prunkdump/arduino-variometer/Modifications/V3/CJMCU-117- Modification du MPU.JPG

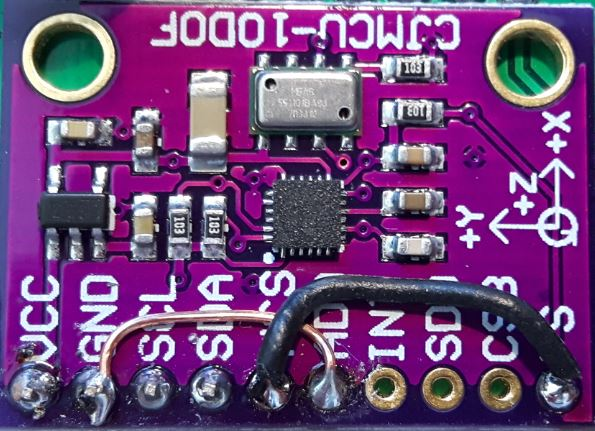
Modifications/V3/CJMCU-117- Modification du MPU.JPG
