prunkdump/arduino-variometer/Modifications/V3/connecteur FDTI.pdf

Problème de temperature

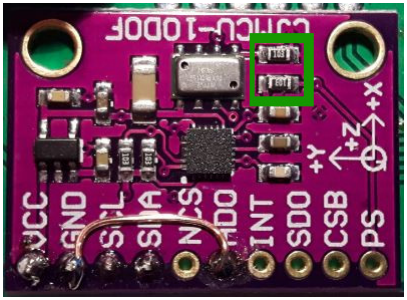
[picture p2: figure]

1- | Connecter la pin AD0 à la pin GND
2- | Connecter la pin NCS à la pin PS

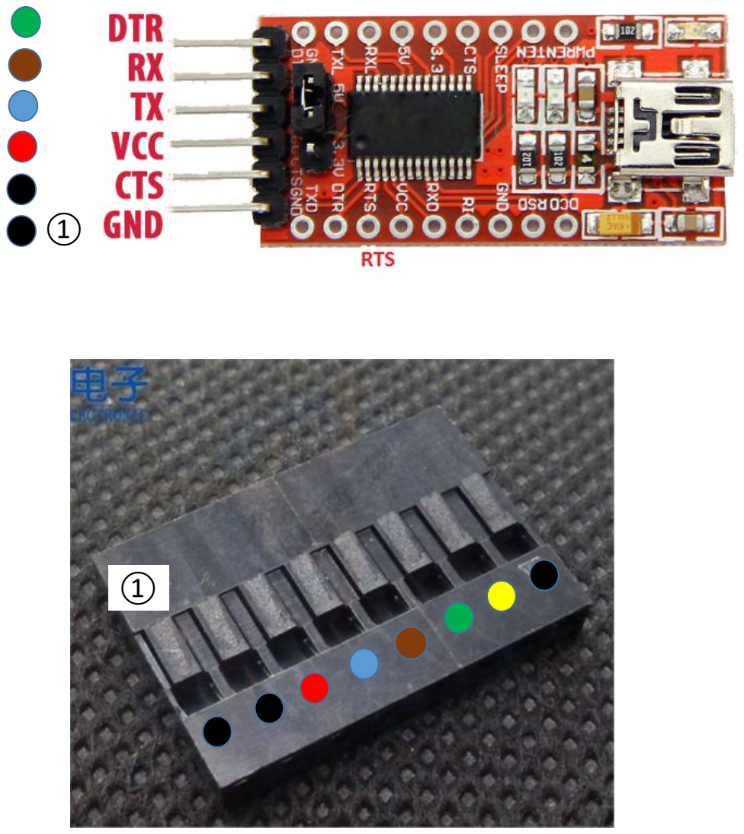
[picture p3: page 2]

①

①

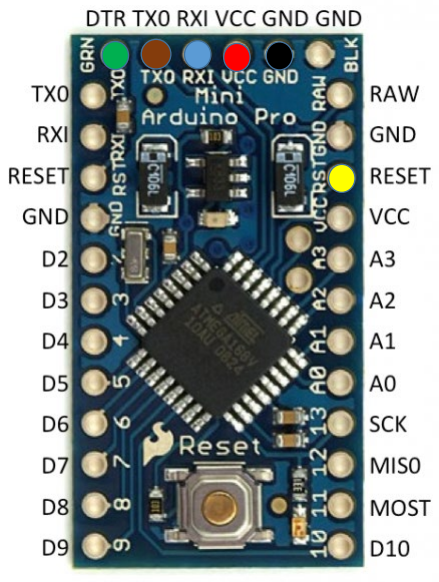
[picture p4: figure]

De gauche à droite écran dessus
Fil | arduino | Connecteur
1 MARRON | GND | GND FTDI
2 ORANGE | GND | CTS FTDI
3 JAUNE | VCC | VCC FTDI
4 ROUGE | RX | TX
5 MARRON | TX | RX
6 VERT | DTR | DTR
7 BLEU | RST | RESET
8 NOIR | GND | GND
