prunkdump/arduino-variometer/(threads)

Thread 1 (2016-12-30):

Thanks

hw999, 2016-12-30:
Hi prunkdump

thanks for publishing your vario solution. It was very helpful for my own project - especially vertaccel and kalmanvert. Performs really nice.

I plan to do make an enhanced version where speed also goes into the equation, known as TECS.
There are already calculations available. But the ones I know don't make a fusion of vertaccel, pressure and speed.
I would like to have this in a Kalman filter - for the time being I lack the knowledge how to do that.

Do you maybe have some hints ?

regards Andi

prunkdump, 2017-01-01:
Hi Andi !

I'am happy that you find my Kalman code helpful ! It was the reason that motivate me starting this project.

I'am interested about your project and how your embed my code. I need as much feedbacks as possible to improve my libraries. Can you send me some ?

This week a have a lot a work. But I can send you a three dimensional Kalman code. I just need a little time to writing it well. But be careful that it will be more computer intensive.

Last question. Do you use your MPU9250 with a 3.5V arduino ? I have some trouble using my Kalman filter with only 3.5V (Atemega328P + MPU9250 + ms5611). But maybe it's an hardware problem.

Maybe you can email me on :

prunkdump at gmail dot com

So I can send you private messages.

Regards, Baptiste.

hw999, 2017-01-17:
Hi Baptiste

I was late with an answer because I didn't notice your reply. Did receive my email ?

kostashellas, 2017-05-03:
Hi Baptiste,
Do you consider changing AVR to something like SAMD21, more performance, memory.
I have a little project that I'm working on the last 6 months and I've reached the Arduino micro limits that's why I've

kostashellas, 2017-05-03:
I'm migrating the entire project to MicroZero that has also SD build-in.
I'm integrating to it your 5611 code and adding the GPS functionality.  All information send to the user   via voice messages thru the headsets.

Best, Kostas

prunkdump, 2017-05-03:
Hi Kostas !

Currently I try to finish my code for Atmega328P as it is the most common hardware used by Arduino hobbyist.

But I can help you if you want. You just want an ms5611 library for cortex M0 ?

Regards, Baptiste.

Thread 2 (2017-04-30):

Moved to variometer kits

jpg63, 2017-04-30:
Le son est un peu fort et il serait intéressant de le régler

Priorité : Indispensable

solution :

Pour le volume c'est effectivement possible de le régler avec le code. Je comptais faire la modif. Il faut remplacer tous les toneAC(freq) en toneAC(freq, VOLUME) avec un volume entre 1 et 10. Mais encore une fois il faut que j'explique comment mettre à jour le code.

van-hurlu, 2017-04-30:
Très facile mettre le code à jour, je l'ai fait pour arrivé à faire fonctionner le baro
si j'ai pigé ma manip
il suffit d'ajouter ,5 juste après la valeur freq dans le code
ou mieux de créer un int vol
et de mettre ,vol après la valeur freq dans le code

prunkdump, 2017-04-30:
Continuez la discution sur variometer-kits.

Closed 2017-04-30.

Thread 4 (2017-04-30):

Enregistrement des données

jpg63, 2017-04-30:
Le vario enregistre toutes les données dès que le gps est fixer, il serait plus judicieux que l'enregistrement débute au début du vol, vitesse supérieur à 3km/h et alti variant de 3m

il serait important d'ajouter l'altitude baro dans le fichier

prunkdump, 2017-04-30:
Continuez la discution sur variometer-kits.

Closed 2017-04-30.

Thread 6 (2017-06-12):

XC Track implementation

YgorTN, 2017-06-12:
Hi Prunk Dump,
I have done several flights with this setup: MS5611, LCD 5110, Speaker and Bluetooth HC-05 using your code (Commits on May 23, 2017 - send vario sentences without GPS). I used it also with XC Soar Android app.

I'm more than satisfied with its performance. Thank you for sharing your idea.

Another, probably more suitable app for paragliders available on Android store is XC Track.
The only problem is, that this app does not support lxnav bluetooth sentence protocol.
This app support only these comercial varios e.g.: FlyNet, BlueFly Vario etc.
http://xctrack.org/External_Sensors.html

Do you think that there is an option to build in some extra protocol (e.g. same as BlueFly Vario), that can user choose in code to make your vario functioning with XC Track?

Thank you.

Regards, Igor

prunkdump, 2017-06-13:
Hi Igor !

Have you tried the XCtrack setup in real condition ? Because on the changelog :

http://xctrack.org/Change_Log.html

there is  :
---------------------------
2016-05-26 0.5.1.2 (development version)

    XCTracer support (baro data only, protocols: XCTRACER, LK8EX1, LXWP0)
---------------------------

So XCtrack should already support LxNav sentences.

Regards,

Baptiste.

YgorTN, 2017-06-14:
Hi Baptiste,

Sure, I've tried the XC Track setup in real condition. I can only connect my HC-05 BT module to the app, but I can't get any measured pressure data in 'Calibration'.

I've tried to switch 'Atmospheric pressure sensor' into option 'Use internal barometer' in the app settings (My phone LG G3 has internal pressure sensor) and in 'Calibration' I see mearured data in real time and vario is working  (not precisely).

In addition, there is no option to choose a specific device or protocol as it is possible in XC Soar app.

I've also tried to use antoher Android smartphone (without internal sensor), but it aslo hasn't been working.

Regards,

Igor

prunkdump, 2017-06-14:
Hi Igor !

It's seems that XCTrack need a higher frequency for the LxNav sentences. If you still have the same version of the code. Try to change :

#define VARIOMETER_SENTENCE_DELAY 2000

in

#define VARIOMETER_SENTENCE_DELAY 500

Baptiste.

YgorTN, 2017-06-15:
Hi Baptiste,

I've already tried to experiment with sentence frequency in range 100 ms - 2000 ms including your suggestion 500 ms. Unfortunately, without any success.

Today I have found this: https://www.xctracer.com/en/faq/?oid=1856&lang=en

The XCTracer support these protocols:
#supported protocols are None, XCTRACER, LK8EX1 or LXWP0

XCTrack (Android): BLE string XCTRACER, forwardGPSSentences=no

Whereas, XCSoar (Android, Kobo): BLE string LXWP0, forwardGPSSentences=yes, choose LXNAV as driver in XCSoar

So this is probably the reason, why current setup works only with XCSoar app.

Igor

prunkdump, 2017-06-17:
I don't think that this is the origin of the problem. It is just that XCTrack understand the "XCTRACER" sentences. So it is possible to send them directly.

Few months ago someone used this code with XCTrack with small adaptations. So it is possible. Sadly I don't have a device to try XCTrack myself. I will try to recontact him to know how he setup the code.

Baptiste.

YgorTN, 2017-06-19:
Hi Baptiste,
That would be perfect, thank you.

Igor

prunkdump, 2017-08-22:
Hi Igor.

The code now support XCTrack with the LK8000 NMEA sentences !

You have just to change in librairies/VarioSettings/VarioSettings.h :

#define VARIOMETER_SENT_LXNAV_SENTENCE
to
#define VARIOMETER_SENT_LK8000_SENTENCE

Thank you very much for the bug report !

Baptiste.

Closed 2017-08-22.

Thread 7 (2017-06-19):

BMP280

Hasi123, 2017-06-19:
Hi,

Thanks for sharing your project. I have a suggestion for you: You could try to implement the Bosch BMP280 barometer sensor. It is much cheaper, than the MS5611 and has almost the same performance.

prunkdump, 2017-06-21:
Yes you're right, this need to be added to the project !

Even if I think that the BMP280 does not really have almost the same performance than the ms5611.

I contact you when I have found the time to work on it.

Thanks !

Baptiste.

Hasi123, 2017-08-26:
I made a quick and dirty adaptation for the BMP280 using Adafruit's library. It works, but is probaby very inefficient. https://github.com/Hasi123/arduino-variometer

Hasi123, 2017-09-03:
I changed Adafruit's library to use your fastwire communication.

prunkdump, 2017-09-13:
Hello Hasi !

I'am really sorry ! I accidentally removed watching on this issue so GitHub don't send me emails when you put your comments.

I checked you work and it seems good ! Have you tried in flight ?

The only problem is that you feed the Kalman filter each time you get a new value from the accelerometer, regardless of if you have a new value from the barometer.

When I have some times, I will try to adapt you code.

Thanks you for the help !

Hasi123, 2017-09-13:
Since I have a broken leg, I cannot test it in flight yet. As soon as I`m able, I will test it.

Hasi123, 2017-10-27:
hi

Hasi123, 2017-10-27:
Finally I can fly again and was able to test the vario. It worked quite well even with my faulty Code. It would be nice to see it implemented with your routine with the interrupts.

Hasi123, 2017-10-28:
So new update: I read through the BMP280 datasheet and the sensor reads the pressure at a stable frequency internally in normal mode, so there is no need to use timers. I changed the BMP280's settings a bit to better suite our application.

Hasi123, 2017-11-20:
Finally I could test the vario in thermally conditions and it works like a charm! I did a 30km flight in the middle of november. It is very accurate and does not suffer from sudden pressure changes due to an increase or decrease in speed, that I sometimes had with my old homemade vario (only barometer with a low pass filter).

prunkdump, 2017-11-22:
That's great !!!

I have just ordered a BMP280 board to improve the code with you.

The BMP280 have multiple modes. The only drawback of using the "continous" mode is that it consume more energy.

When I have the time to work on It I will sent to you a version of the code with timers interrupts. So you can compare the two versions.

I'm also very interested by you 1.8V setup !

Good job !

Baptiste.

m00nsp3ll, 2019-04-05:
bmp280 have also temperature sensor on it, it could be useful to implement temperature data into vario if bmp280 usage is possible

Hasi123, 2019-04-15:
The temperature data from the barometer is actually used to compensate altitude readings with both the ms5611 and the BMP280.

It would be interesting to test the BMP388, because it has even more resolution and accuracy than older sensors...

prunkdump, 2019-04-27:
The code now support the BMP280 barometer.

Thanks for the report.

Closed 2019-04-27.

Thread 8 (2017-07-29):

Vertical speed but no change in altitude

sbishop61, 2017-07-29:
HI,\ a great project and contribution.

I have a breadboard set up with Pro Mini,  display and MPU9250 & MS5611.

When it is not moving on the desk, the altitude does not change but there is always a vertical speed reported; typically +0.3. After 5 minutes the altitude is still the same and the there has always been a vertical speed.

I thought that the vertical acceleration from the DMP was used in a kalman filter applied to the pressure (altitude) reading. I don't understand how if the altitude is not changing.

Any help appreciated.

Regards,\Stephen

prunkdump, 2017-07-31:
Hi Stephen !

I very happy you like my project.

The kalman filter is not a "long term" filtering algorithm. It use just, each time, the previous step and the new value. Search for "kalman filter" on the web for an introducing article.

Now what's happen in you case. The DMP is bad calibrated so it sent constantly an upward force. The barometer sent nearly always the same altitude.

-> on one step the kalman filter receive 235m and an upward force.
-> as the upward force must increase the vertical speed it assume a +0.3 vertical speed.
-> the next step, the kalman filter receive again 235m and the same upward force. This is not coherent with the privious measure as the altitude have not encreased. So the kalman filter try to make the best assumption.

There is an upward force so the vertical speed must be encrease. But the altitude remain the same so vertical speed must be 0. So il choose 0.3 again.

Otherwise you need to calibrate your gps. Use the "calibration" or the "calibration_nointerractive" sketch.

Don't hesitate if you have questions.

Regards.

Baptiste.

sbishop61, 2017-07-31:
Baptiste,

I assumed that the kalman was used to smooth/filter the pressure readings and that the vertical velocity was calculated from the change in the compensated altitude. In that scenario a constant acceleration might effect the filter output but if the altitude was constant the vertical velocity would always be zero.

I have tried to use the calibration routines but it is hard when on a breadboard. When I ran the calibration it always failed saying BAD measurement.

regards,

Stephen

________________________________
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

prunkdump, 2017-08-02:
Hi Stephen !

Are you sure that you always obtain bad measurement ? Normally you should obtain at least one good measure for each orientation the first time. The second time you get "bad" measure if the acceleroleter is less stabilized than the fist time. Do not touch the breadboard during measurement.

Another tips. Take a box and fix the breadboard inside with tape. So you can use the calibration_nointeractive sketch following this procedure :

https://www.youtube.com/watch?v=fc0vIsZJvsw

Good luck.

Baptiste.

prunkdump, 2017-08-22:
Hi Stephen !

It's seems that you find the problem.

I close the issue.

Baptiste.

Closed 2017-08-22.

Thread 9 (2017-08-02):

Suggestion: extra Define to set MPU I2C address to 0x69

sbishop61, 2017-08-02:
Baptiste,
 in order to try and get a prototype into a box to calibrate I have used a cjmcu-117 as I think you have.
Unfortunately there seems to be some short on the board as the I2c address keeps changing from 0x68 to 0x69 and back again. The solution is to set ADO to 1 which holds the address at 0x69.

I can get it to work by editing inv_mpu.cpp where #define GYRO_HW_ADDR (0x68) is set both for MPU6050 and separately for MPU6500.

A suggestion would be to have a define in VarioSettings.h rather than in the C++ file.

regards
Stephen

prunkdump, 2019-04-14:
You can now set the MPU address in VarioSetting.h

Thanks for the report.

Baptiste.

Closed 2019-04-14.

Thread 10 (2017-08-19):

arduino-variometer to android-variometer?

lshachar, 2017-08-19:
I watched the videos on youtube - and your project seems quite impressive!
on my galaxy s4 smartphone there is a bmp180 barometric sensor, and obviously a 9dof sensor.

It appears that none of the currently available android vario apps integrate the 9dof sensor..
Do you think a port to android may be feasible?
I'm trying to figure out if I can do it myself, but I'm not a very good programmer (I'm experienced with arduino, but not at all with android... I might just end up building your project, will take me less time than trying to port the code to android!)
I'll be happy to hear your thoughts about it!

lshachar, 2017-08-19:
hmmm...
[use sensor fusion to improve vario responsiveness ](https://github.com/msarto/AVario/issues/2)

prunkdump, 2017-08-22:
I Ishachar.

Excuse me for this late reply !

Sadly I don't have any practice in Android programming. But I know that :
-> It's possible to use C++ with Android with Android NDK so you can port some part of this code.
-> It's possible to access the 9dof and bmp180 data with Android libraries.

So porting this project to android seems to be possible ! If I find some more info I will send to you the links.

Thanks for the idea !

Baptiste.

Thread 11 (2017-10-19):

vario + bluetooth+ gps = no sentences

lshachar, 2017-10-19:
Hello prunkdump!
I have built a vario using your code. A+++ stuff! thank you!!
I now got a GPS and Bluetooth installed in my vario, and I think I'm onto a bug.

in variometer.ino:323 `#else //!HAVE_GPS`
When there is GPS installed, but GPS didn't get a fix, no sentences will be sent.
I believe that this is unintentional behavior; in this case the vario should send pressure and vario data, neglecting calibrated altitude (since it cannot be calibrated - no GPS).

once GPS gets a fix, calibrated altitude should be sent.
I think that excluding this code (with line 323) when there is GPS and Bluetooth is the problem.
Do you agree?

prunkdump, 2017-10-20:
Hi Ishachar.

No there is no problem. I explain.

When the variometer sent pressure/vario sentences it must be carefull to not sending the sentences at the same time than GPS. Because they use the same serial port. So synchronization is needed between the GPS and the variometer.

So :
-> When the GPS is installed. Pressure/Vario sentences are sent just after the last GPS sentence. It's the GPS that give the rate of the Pressure/Vario Sentences. Search for "lastSentence = true;" in the code. And the GPS sent the sentences even if it didn't get a fix.

-> When there is no GPS installed. The variometer is free to sent the sentences when it want. So there is just a delay between sending. And the "last sentence" code is disabled. This delay can be set in "VarioSettings.h".

Regards,

Baptiste.

jpg63, 2017-10-20:
Salut Baptiste,

tu as du mélanger mon mail avec celui de Ishachar

Pense à lui renvoyer ta réponse

A+

________________________________
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

kostashellas, 2017-10-20:
Hi Baptiste,
That means the vario refresh rate, in case of  GPS, = GPS refresh rate thus
20Hz?

Regards Kostas

On Oct 20, 2017 11:28 AM, "prunkdump" <notifications@github.com> wrote:

Hi Ishachar.

No there is no problem. I explain.

When the variometer sent pressure/vario sentences it must be carefull to
not sending the sentences at the same time than GPS. Because they use the
same serial port. So synchronization is needed between the GPS and the
variometer.

So :
-> When the GPS is installed. Pressure/Vario sentences are sent just after
the last GPS sentence. It's the GPS that give the rate of the
Pressure/Vario Sentences. Search for "lastSentence = true;" in the code.
And the GPS sent the sentences even if it didn't get a fix.

-> When there is no GPS installed. The variometer is free to sent the
sentences when it want. So there is just a delay between sending. And the
"last sentence" code is disabled. This delay can be set in
"VarioSettings.h".

Regards,

Baptiste.

—
You are receiving this because you are subscribed to this thread.
Reply to this email directly, view it on GitHub
<https://github.com/prunkdump/arduino-variometer/issues/11#issuecomment-338141728>,
or mute the thread
<https://github.com/notifications/unsubscribe-auth/ABPYiFmlG5yfHuDyAmC2v53xKtbRdmyIks5suFm0gaJpZM4P_2cq>
.

prunkdump, 2017-10-21:
Yes ! I known that this must be improved !

GPS often use a refresh rate of 0.5Htz. One time every two seconds. And for the Pressure/Vario sentences it's a little bit slow.

Thanks for the report !

defvs, 2018-01-08:
How about using SoftwareSerial, by changing bluetooth pins and completely separating the two ? I know there is a rom space issue, but with a little tweaking it could be almost invisible.

**Français**
Pourquoi on utiliserais pas SoftwareSerial ? On change les pins du bluetooth et on sépare complètement les deux ? Apparement il y a peu de place dans la rom avec le programme mais avec un peu de tweak on peut réussir à négliger l'impact sur le processeur de l'arduino

If you need more help just ask me; si tu veux plus d'infos demande moi

prunkdump, 2018-01-08:
Hi Defvs !

There is two problems with SoftwareSerial :

-> Obviously, SoftwareSerial consume more ROM as the Serial protocol internals are implemented by software and not by hardware.

-> SoftwareSerial (like Serial) use two ring buffers, one for RX and one for TX. The SerialNmea library use only one common buffer and filter the input (RX) characters to keep only the needed NMEA sentences.

Thus we save ROM with optimized code but also SRAM with the only one (small) ring buffer.

But you're right. The drawback is that the code is not portable and only the hardware serial pins can be used.

But if you want, software serial can be easily used inside SerialNmea to use some other pins.

Thanks for the suggestion !

Baptiste.

defvs, 2018-01-08:
Hey ! I'll try and make a port ;)

Le lun. 8 janv. 2018 à 16:20, prunkdump <notifications@github.com> a écrit :

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
--

Merci,
Daniel Thirion (defvs) defvs.daniel@gmail.com

lshachar, 2019-09-11:
I went back to enabling the GPS module on my vario (I decided to disable it back in October 2017..)
And I found the cause of my original issues.
I am using a chinese arduino nano, which has a CH340 chip instead of an FTDI chip. (for USB to serial).
My GPS module, NEO-6m, wasn't able to sink the RX1 pin (on the arduino) to LOW. So even though the GPS module was in fact sending NMEA sentences at 1HZ, the cheap arduino nano did not see that data on its RX1 line.
(I figured that out by using the software serial library, and connecting the GPS TX pin to arduino on a different pin (pin 2). which worked fine.)
Hence, the CH340 is doing something funny - maybe it has a small pull up resistor when it is not trying to send data to the arduino.

In order to solve the problem: I added a PNP transistor (2N4403 I had laying around) between the gps module (TX) and the arduino (RX) that sinks the RX pin to Ground (when the gate goes low - which is connected to the GPS TX pin).
once the arduino received the data on the RX line, I was able to `#define HAVE_GPS` in `variosettings.h` and the info is sent properly on the arduino's TX line (both the gps' NMEA sentences and the vario's LK8000 sentences.

I also learned something else...:
while sending data to the arduino through the serial interface (through UART, which ends up on the arduino's RX1 pin) and at the same time having the GPS module trying to send data (because that's what it does every second)  - I had something goes up in smoke! and that cheap arduino board died. well, probably only the CH340 died as that board won't connect through USB anymore. but otherwise it still works.
I assume that the CH340 tried to drain too much current (both the arduino RX1 and the GPS module should have pullup resistors; once the CH340 was trying to send data it tried to sink both these sources to ground (before the NPN transistor was added) ).
To play it on the safe side I added a SPDT switch on the RX1 pin, and now I disconnect the NPN transistor every time before I upload any code.
(I believe adding a resistor on the transistor's gate, should also keep this from happening again, but I'm not 100% sure that the CH340 burned, and that it happened for the reason I think it did. So I'm playing it safe).

This wouldn't have happened if I used a genuine arduino board.
I wanted to get this information out there in case it help somebody one day.

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

Closed 2020-04-07.

Thread 12 (2017-11-23):

SETTINGS.TXT

pbwild, 2017-11-23:
Hi!
Could you post an example of the SETTINGS.TXT file for the M0 branch?
Man thanks!
Peter

jpg63, 2017-11-23:
https://github.com/prunkdump/arduino-variometer/tree/jpg63-M0-version/libraries/VarioSettings

[https://avatars2.githubusercontent.com/u/4787331?s=400&v=4]<https://github.com/prunkdump/arduino-variometer/tree/jpg63-M0-version/libraries/VarioSettings>

prunkdump/arduino-variometer<https://github.com/prunkdump/arduino-variometer/tree/jpg63-M0-version/libraries/VarioSettings>
github.com
arduino-variometer - Arduino based variometer with accelerometer, screen, gps and sdcard code

Hi, the file SETTINGS.TXT is present in the directory variosetting This file is placed in the root of the SD card

jpg63

________________________________
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

pbwild, 2017-11-25:
Ah yes - found it!
Many thanks!

Thread 13 (2017-11-30):

M0 Accelerometer Calibration

pbwild, 2017-11-30:
Hi,
do you have a tip on how to calibrate the MPU9250 Accelerometer on the M0 branch. I have got the sketch up and running on an Arduino Zero without an SD Card (btw. in the code VarioSettings GnuSettings; needs to be moved outside the #ifdef HAVE_SDCARD for this to work), but I'm not getting very far with the calibration sketches - I don't quite understand what you are doing with Fastwire.
Many thanks,
Peter

jpg63, 2017-11-30:
Hi,

The calibration of the MPU9250 is not yet implemented in this code, it will come later. For the Gnusettings library it is imperative to have an SD card, the MKRZero has one of them. The setting is stored in SETTINGS.TXT at the root of the SD card. Without SD card the code does not work, it will be possible to make changes later but I do not see the interest.

jpg63

________________________________
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

pbwild, 2017-12-03:
OK thanks, looking forward on seeing how you calibrate things on the zero platfom.
Cheers,
Peter

DonCann, 2017-12-08:
I adapted the calibration code t from the samd21 branch to make it work with the zero, doesn't work though, I keep getting this message for any orientation, for instance pointing upward:

accel=(-0.01402, 0.00588, 0.11548)
Standard deviation = 0.62822
BAD measure, not recorded, possible problems are :
-> ambiguous orientation
-> orientation already done with lower standard deviation

Any idea why the orientation is ambiguous?

prunkdump, 2017-12-09:
Hello !

This is not the problem. "Standard deviation" is just the measure of acceleration data "quality". For each orientations, the calibrator record the measure only if the Standard deviation is lower than the previous measure.

The problem is that your accel vector give strange data :
accel=(-0.01402, 0.00588, 0.11548)

Normally, the norm of the vector must be around 1 (due to gravity) with is not the case here. Two possibilities :
-> You MPU9250 does not work well.
-> There is a problem in the Samd21 code.

I have tested the vertaccel_library on Samd21 and it work well. I think than Jpg63 have tested the calibration code without midification.

Can you confirm Jpg63 ?

Don't hesitate if you have questions or if you find something.

Baptiste.

jpg63, 2017-12-09:
Hello The code is that of the original accelcalibrator library and the last MPU library that was tested with the samd21. I did not make any changes other than saving the calibration in memory and on the SD card jpg63

________________________________
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

DonCann, 2017-12-11:
Thank you both for your answers, I’ll test with another mpu and let you know.
Cheers

pbwild, 2017-12-30:
Hi,
I've just got everything up and running on an MKR0, but I'm still unclear on how to calibrate.
Is what DonCann is trying the correct way to proceed?
@DonCann - care to share any progress with your code modification?
Many thanks,
Peter

prunkdump, 2018-01-08:
Hi PbWild !

Which branch do you use ?
-> If you use the master-Samd21 branch the accelerometer calibration is not implemented yet.
-> If you use the jpg63-M0-version branch, the calibration procedure is automatically launched at power On If not already done. And you need to follow there steps :

https://www.youtube.com/watch?v=fc0vIsZJvsw

DonCann, 2018-01-17:
I tested my code with two different mpu-9250 and in both cases got values in the 0.01-0.10 range as I mentionned above.
Will report when I find where the problem.

prunkdump, 2018-01-20:
I'am really sorry ! You're right. There is a bug in the calibrator that can cause overflow with high speed micro controllers.

The bug is corrected in the master branch.

I will send to you a Samd21 version soon.

Sorry again. The problem was not your mpu9250 ...

prunkdump, 2018-01-20:
The problem is now corrected. The "calibration.ino" sketch run and display correct values. But the calibration correction coefficient are still not recorded.

Jpg63 you need to port the last correction to your branch ;)

jpg63, 2018-01-20:
I have already updated my pro-mini branch. For the M0 version, the libraries are very different, I have to look

________________________________
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

pbwild, 2018-02-16:
Hi, any updates on calibration for the M0 branch? Where exactly should the coefficients be saved - eeprom or flash.txt?
Thanks,
Peter

jpg63, 2018-02-16:
Hi,

The parameters are stored in 2. The eeprom of the M0 is removed at each program update. Parameters are taken first on the eeprom and if they are zero, on the SDcard in a specific file

jean-philippe
________________________________
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

kostashellas, 2018-02-16:
Hi JP,

SAMD21 has no EEPROM if not mistaken, do you mean from RAM to Flash?

Flash Memory 256 KB
Flash Memory for Bootloader 8 KB
SRAM 32 KB
EEPROM no
Best, Kostas

On Feb 16, 2018 3:00 PM, "jpg63" <notifications@github.com> wrote:

Hi,

The parameters are stored in 2. The eeprom of the M0 is removed at each
program update. Parameters are taken first on the eeprom and if they are
zero, on the SDcard in a specific file

jean-philippe
________________________________
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

jpg63, 2018-02-16:
actually the M0 has no eeprom but it is possible to use the program memory, with the default of seeing the parameters erased at each update

________________________________
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

Thread 15 (2018-01-26):

Cant compille ino.

damirm57, 2018-01-26:
Hi I can  not compile variometar ino. mesage is:
Arduino: 1.6.12 (Windows 7), TD: 1.35, Board: "Arduino Pro or Pro Mini, ATmega328 (5V, 16 MHz)"

C:\Program Files (x86)\Arduino\arduino-builder -dump-prefs -logger=machine -hardware C:\Program Files (x86)\Arduino\hardware -hardware C:\Users\damir\AppData\Local\Arduino15\packages -tools C:\Program Files (x86)\Arduino\tools-builder -tools C:\Program Files (x86)\Arduino\hardware\tools\avr -tools C:\Users\damir\AppData\Local\Arduino15\packages -built-in-libraries C:\Program Files (x86)\Arduino\libraries -libraries C:\Users\damir\Documents\Arduino\libraries -fqbn=arduino:avr:pro:cpu=16MHzatmega328 -ide-version=10612 -build-path C:\Users\damir\AppData\Local\Temp\arduino_build_833406 -warnings=none -prefs=build.warn_data_percentage=75 -prefs=runtime.tools.avrdude.path=C:\Program Files (x86)\Arduino\hardware\tools\avr -prefs=runtime.tools.avr-gcc.path=C:\Program Files (x86)\Arduino\hardware\tools\avr -verbose C:\Users\damir\Desktop\arduino-variometer-master (1)\arduino-variometer-master\variometer\variometer.ino
C:\Program Files (x86)\Arduino\arduino-builder -compile -logger=machine -hardware C:\Program Files (x86)\Arduino\hardware -hardware C:\Users\damir\AppData\Local\Arduino15\packages -tools C:\Program Files (x86)\Arduino\tools-builder -tools C:\Program Files (x86)\Arduino\hardware\tools\avr -tools C:\Users\damir\AppData\Local\Arduino15\packages -built-in-libraries C:\Program Files (x86)\Arduino\libraries -libraries C:\Users\damir\Documents\Arduino\libraries -fqbn=arduino:avr:pro:cpu=16MHzatmega328 -ide-version=10612 -build-path C:\Users\damir\AppData\Local\Temp\arduino_build_833406 -warnings=none -prefs=build.warn_data_percentage=75 -prefs=runtime.tools.avrdude.path=C:\Program Files (x86)\Arduino\hardware\tools\avr -prefs=runtime.tools.avr-gcc.path=C:\Program Files (x86)\Arduino\hardware\tools\avr -verbose C:\Users\damir\Desktop\arduino-variometer-master (1)\arduino-variometer-master\variometer\variometer.ino
Using board 'pro' from platform in folder: C:\Users\damir\AppData\Local\Arduino15\packages\arduino\hardware\avr\1.6.20
Using core 'arduino' from platform in folder: C:\Users\damir\AppData\Local\Arduino15\packages\arduino\hardware\avr\1.6.20
Detecting libraries used...
"C:\Program Files (x86)\Arduino\hardware\tools\avr/bin/avr-g++" -c -g -Os -w -std=gnu++11 -fpermissive -fno-exceptions -ffunction-sections -fdata-sections -fno-threadsafe-statics  -flto -w -x c++ -E -CC -mmcu=atmega328p -DF_CPU=16000000L -DARDUINO=10612 -DARDUINO_AVR_PRO -DARDUINO_ARCH_AVR   "-IC:\Users\damir\AppData\Local\Arduino15\packages\arduino\hardware\avr\1.6.20\cores\arduino" "-IC:\Users\damir\AppData\Local\Arduino15\packages\arduino\hardware\avr\1.6.20\variants\eightanaloginputs" "C:\Users\damir\AppData\Local\Temp\arduino_build_833406\sketch\variometer.ino.cpp" -o "nul"
"C:\Program Files (x86)\Arduino\hardware\tools\avr/bin/avr-g++" -c -g -Os -w -std=gnu++11 -fpermissive -fno-exceptions -ffunction-sections -fdata-sections -fno-threadsafe-statics  -flto -w -x c++ -E -CC -mmcu=atmega328p -DF_CPU=16000000L -DARDUINO=10612 -DARDUINO_AVR_PRO -DARDUINO_ARCH_AVR   "-IC:\Users\damir\AppData\Local\Arduino15\packages\arduino\hardware\avr\1.6.20\cores\arduino" "-IC:\Users\damir\AppData\Local\Arduino15\packages\arduino\hardware\avr\1.6.20\variants\eightanaloginputs" "-IC:\Users\damir\AppData\Local\Arduino15\packages\arduino\hardware\avr\1.6.20\libraries\SPI\src" "C:\Users\damir\AppData\Local\Temp\arduino_build_833406\sketch\variometer.ino.cpp" -o "nul"
"C:\Program Files (x86)\Arduino\hardware\tools\avr/bin/avr-g++" -c -g -Os -w -std=gnu++11 -fpermissive -fno-exceptions -ffunction-sections -fdata-sections -fno-threadsafe-statics  -flto -w -x c++ -E -CC -mmcu=atmega328p -DF_CPU=16000000L -DARDUINO=10612 -DARDUINO_AVR_PRO -DARDUINO_ARCH_AVR   "-IC:\Users\damir\AppData\Local\Arduino15\packages\arduino\hardware\avr\1.6.20\cores\arduino" "-IC:\Users\damir\AppData\Local\Arduino15\packages\arduino\hardware\avr\1.6.20\variants\eightanaloginputs" "-IC:\Users\damir\AppData\Local\Arduino15\packages\arduino\hardware\avr\1.6.20\libraries\SPI\src" "-IC:\Users\damir\Documents\Arduino\libraries\VarioSettings" "C:\Users\damir\AppData\Local\Temp\arduino_build_833406\sketch\variometer.ino.cpp" -o "nul"
"C:\Program Files (x86)\Arduino\hardware\tools\avr/bin/avr-g++" -c -g -Os -w -std=gnu++11 -fpermissive -fno-exceptions -ffunction-sections -fdata-sections -fno-threadsafe-statics  -flto -w -x c++ -E -CC -mmcu=atmega328p -DF_CPU=16000000L -DARDUINO=10612 -DARDUINO_AVR_PRO -DARDUINO_ARCH_AVR   "-IC:\Users\damir\AppData\Local\Arduino15\packages\arduino\hardware\avr\1.6.20\cores\arduino" "-IC:\Users\damir\AppData\Local\Arduino15\packages\arduino\hardware\avr\1.6.20\variants\eightanaloginputs" "-IC:\Users\damir\AppData\Local\Arduino15\packages\arduino\hardware\avr\1.6.20\libraries\SPI\src" "-IC:\Users\damir\Documents\Arduino\libraries\VarioSettings" "-IC:\Users\damir\Documents\Arduino\libraries\I2CDev_ms5611" "C:\Users\damir\AppData\Local\Temp\arduino_build_833406\sketch\variometer.ino.cpp" -o "nul"
"C:\Program Files (x86)\Arduino\hardware\tools\avr/bin/avr-g++" -c -g -Os -w -std=gnu++11 -fpermissive -fno-exceptions -ffunction-sections -fdata-sections -fno-threadsafe-statics  -flto -w -x c++ -E -CC -mmcu=atmega328p -DF_CPU=16000000L -DARDUINO=10612 -DARDUINO_AVR_PRO -DARDUINO_ARCH_AVR   "-IC:\Users\damir\AppData\Local\Arduino15\packages\arduino\hardware\avr\1.6.20\cores\arduino" "-IC:\Users\damir\AppData\Local\Arduino15\packages\arduino\hardware\avr\1.6.20\variants\eightanaloginputs" "-IC:\Users\damir\AppData\Local\Arduino15\packages\arduino\hardware\avr\1.6.20\libraries\SPI\src" "-IC:\Users\damir\Documents\Arduino\libraries\VarioSettings" "-IC:\Users\damir\Documents\Arduino\libraries\I2CDev_ms5611" "-IC:\Users\damir\Documents\Arduino\libraries\ms5611" "C:\Users\damir\AppData\Local\Temp\arduino_build_833406\sketch\variometer.ino.cpp" -o "nul"
"C:\Program Files (x86)\Arduino\hardware\tools\avr/bin/avr-g++" -c -g -Os -w -std=gnu++11 -fpermissive -fno-exceptions -ffunction-sections -fdata-sections -fno-threadsafe-statics  -flto -w -x c++ -E -CC -mmcu=atmega328p -DF_CPU=16000000L -DARDUINO=10612 -DARDUINO_AVR_PRO -DARDUINO_ARCH_AVR   "-IC:\Users\damir\AppData\Local\Arduino15\packages\arduino\hardware\avr\1.6.20\cores\arduino" "-IC:\Users\damir\AppData\Local\Arduino15\packages\arduino\hardware\avr\1.6.20\variants\eightanaloginputs" "-IC:\Users\damir\AppData\Local\Arduino15\packages\arduino\hardware\avr\1.6.20\libraries\SPI\src" "-IC:\Users\damir\Documents\Arduino\libraries\VarioSettings" "-IC:\Users\damir\Documents\Arduino\libraries\I2CDev_ms5611" "-IC:\Users\damir\Documents\Arduino\libraries\ms5611" "-IC:\Users\damir\Documents\Arduino\libraries\vertaccel" "C:\Users\damir\AppData\Local\Temp\arduino_build_833406\sketch\variometer.ino.cpp" -o "nul"
"C:\Program Files (x86)\Arduino\hardware\tools\avr/bin/avr-g++" -c -g -Os -w -std=gnu++11 -fpermissive -fno-exceptions -ffunction-sections -fdata-sections -fno-threadsafe-statics  -flto -w -x c++ -E -CC -mmcu=atmega328p -DF_CPU=16000000L -DARDUINO=10612 -DARDUINO_AVR_PRO -DARDUINO_ARCH_AVR   "-IC:\Users\damir\AppData\Local\Arduino15\packages\arduino\hardware\avr\1.6.20\cores\arduino" "-IC:\Users\damir\AppData\Local\Arduino15\packages\arduino\hardware\avr\1.6.20\variants\eightanaloginputs" "-IC:\Users\damir\AppData\Local\Arduino15\packages\arduino\hardware\avr\1.6.20\libraries\SPI\src" "-IC:\Users\damir\Documents\Arduino\libraries\VarioSettings" "-IC:\Users\damir\Documents\Arduino\libraries\I2CDev_ms5611" "-IC:\Users\damir\Documents\Arduino\libraries\ms5611" "-IC:\Users\damir\Documents\Arduino\libraries\vertaccel" "-IC:\Users\damir\Documents\Arduino\libraries\LightInvensense" "C:\Users\damir\AppData\Local\Temp\arduino_build_833406\sketch\variometer.ino.cpp" -o "nul"
"C:\Program Files (x86)\Arduino\hardware\tools\avr/bin/avr-g++" -c -g -Os -w -std=gnu++11 -fpermissive -fno-exceptions -ffunction-sections -fdata-sections -fno-threadsafe-statics  -flto -w -x c++ -E -CC -mmcu=atmega328p -DF_CPU=16000000L -DARDUINO=10612 -DARDUINO_AVR_PRO -DARDUINO_ARCH_AVR   "-IC:\Users\damir\AppData\Local\Arduino15\packages\arduino\hardware\avr\1.6.20\cores\arduino" "-IC:\Users\damir\AppData\Local\Arduino15\packages\arduino\hardware\avr\1.6.20\variants\eightanaloginputs" "-IC:\Users\damir\AppData\Local\Arduino15\packages\arduino\hardware\avr\1.6.20\libraries\SPI\src" "-IC:\Users\damir\Documents\Arduino\libraries\VarioSettings" "-IC:\Users\damir\Documents\Arduino\libraries\I2CDev_ms5611" "-IC:\Users\damir\Documents\Arduino\libraries\ms5611" "-IC:\Users\damir\Documents\Arduino\libraries\vertaccel" "-IC:\Users\damir\Documents\Arduino\libraries\LightInvensense" "-IC:\Users\damir\AppData\Local\Arduino15\packages\arduino\hardware\avr\1.6.20\libraries\EEPROM\src" "C:\Users\damir\AppData\Local\Temp\arduino_build_833406\sketch\variometer.ino.cpp" -o "nul"
"C:\Program Files (x86)\Arduino\hardware\tools\avr/bin/avr-g++" -c -g -Os -w -std=gnu++11 -fpermissive -fno-exceptions -ffunction-sections -fdata-sections -fno-threadsafe-statics  -flto -w -x c++ -E -CC -mmcu=atmega328p -DF_CPU=16000000L -DARDUINO=10612 -DARDUINO_AVR_PRO -DARDUINO_ARCH_AVR   "-IC:\Users\damir\AppData\Local\Arduino15\packages\arduino\hardware\avr\1.6.20\cores\arduino" "-IC:\Users\damir\AppData\Local\Arduino15\packages\arduino\hardware\avr\1.6.20\variants\eightanaloginputs" "-IC:\Users\damir\AppData\Local\Arduino15\packages\arduino\hardware\avr\1.6.20\libraries\SPI\src" "-IC:\Users\damir\Documents\Arduino\libraries\VarioSettings" "-IC:\Users\damir\Documents\Arduino\libraries\I2CDev_ms5611" "-IC:\Users\damir\Documents\Arduino\libraries\ms5611" "-IC:\Users\damir\Documents\Arduino\libraries\vertaccel" "-IC:\Users\damir\Documents\Arduino\libraries\LightInvensense" "-IC:\Users\damir\AppData\Local\Arduino15\packages\arduino\hardware\avr\1.6.20\libraries\EEPROM\src" "-IC:\Users\damir\Documents\Arduino\libraries\kalmanvert" "C:\Users\damir\AppData\Local\Temp\arduino_build_833406\sketch\variometer.ino.cpp" -o "nul"
"C:\Program Files (x86)\Arduino\hardware\tools\avr/bin/avr-g++" -c -g -Os -w -std=gnu++11 -fpermissive -fno-exceptions -ffunction-sections -fdata-sections -fno-threadsafe-statics  -flto -w -x c++ -E -CC -mmcu=atmega328p -DF_CPU=16000000L -DARDUINO=10612 -DARDUINO_AVR_PRO -DARDUINO_ARCH_AVR   "-IC:\Users\damir\AppData\Local\Arduino15\packages\arduino\hardware\avr\1.6.20\cores\arduino" "-IC:\Users\damir\AppData\Local\Arduino15\packages\arduino\hardware\avr\1.6.20\variants\eightanaloginputs" "-IC:\Users\damir\AppData\Local\Arduino15\packages\arduino\hardware\avr\1.6.20\libraries\SPI\src" "-IC:\Users\damir\Documents\Arduino\libraries\VarioSettings" "-IC:\Users\damir\Documents\Arduino\libraries\I2CDev_ms5611" "-IC:\Users\damir\Documents\Arduino\libraries\ms5611" "-IC:\Users\damir\Documents\Arduino\libraries\vertaccel" "-IC:\Users\damir\Documents\Arduino\libraries\LightInvensense" "-IC:\Users\damir\AppData\Local\Arduino15\packages\arduino\hardware\avr\1.6.20\libraries\EEPROM\src" "-IC:\Users\damir\Documents\Arduino\libraries\kalmanvert" "-IC:\Users\damir\Documents\Arduino\libraries\beeper" "C:\Users\damir\AppData\Local\Temp\arduino_build_833406\sketch\variometer.ino.cpp" -o "nul"
"C:\Program Files (x86)\Arduino\hardware\tools\avr/bin/avr-g++" -c -g -Os -w -std=gnu++11 -fpermissive -fno-exceptions -ffunction-sections -fdata-sections -fno-threadsafe-statics  -flto -w -x c++ -E -CC -mmcu=atmega328p -DF_CPU=16000000L -DARDUINO=10612 -DARDUINO_AVR_PRO -DARDUINO_ARCH_AVR   "-IC:\Users\damir\AppData\Local\Arduino15\packages\arduino\hardware\avr\1.6.20\cores\arduino" "-IC:\Users\damir\AppData\Local\Arduino15\packages\arduino\hardware\avr\1.6.20\variants\eightanaloginputs" "-IC:\Users\damir\AppData\Local\Arduino15\packages\arduino\hardware\avr\1.6.20\libraries\SPI\src" "-IC:\Users\damir\Documents\Arduino\libraries\VarioSettings" "-IC:\Users\damir\Documents\Arduino\libraries\I2CDev_ms5611" "-IC:\Users\damir\Documents\Arduino\libraries\ms5611" "-IC:\Users\damir\Documents\Arduino\libraries\vertaccel" "-IC:\Users\damir\Documents\Arduino\libraries\LightInvensense" "-IC:\Users\damir\AppData\Local\Arduino15\packages\arduino\hardware\avr\1.6.20\libraries\EEPROM\src" "-IC:\Users\damir\Documents\Arduino\libraries\kalmanvert" "-IC:\Users\damir\Documents\Arduino\libraries\beeper" "-IC:\Users\damir\Documents\Arduino\libraries\LPtoneAC" "C:\Users\damir\AppData\Local\Temp\arduino_build_833406\sketch\variometer.ino.cpp" -o "nul"
"C:\Program Files (x86)\Arduino\hardware\tools\avr/bin/avr-g++" -c -g -Os -w -std=gnu++11 -fpermissive -fno-exceptions -ffunction-sections -fdata-sections -fno-threadsafe-statics  -flto -w -x c++ -E -CC -mmcu=atmega328p -DF_CPU=16000000L -DARDUINO=10612 -DARDUINO_AVR_PRO -DARDUINO_ARCH_AVR   "-IC:\Users\damir\AppData\Local\Arduino15\packages\arduino\hardware\avr\1.6.20\cores\arduino" "-IC:\Users\damir\AppData\Local\Arduino15\packages\arduino\hardware\avr\1.6.20\variants\eightanaloginputs" "-IC:\Users\damir\AppData\Local\Arduino15\packages\arduino\hardware\avr\1.6.20\libraries\SPI\src" "-IC:\Users\damir\Documents\Arduino\libraries\VarioSettings" "-IC:\Users\damir\Documents\Arduino\libraries\I2CDev_ms5611" "-IC:\Users\damir\Documents\Arduino\libraries\ms5611" "-IC:\Users\damir\Documents\Arduino\libraries\vertaccel" "-IC:\Users\damir\Documents\Arduino\libraries\LightInvensense" "-IC:\Users\damir\AppData\Local\Arduino15\packages\arduino\hardware\avr\1.6.20\libraries\EEPROM\src" "-IC:\Users\damir\Documents\Arduino\libraries\kalmanvert" "-IC:\Users\damir\Documents\Arduino\libraries\beeper" "-IC:\Users\damir\Documents\Arduino\libraries\LPtoneAC" "-IC:\Users\damir\Documents\Arduino\libraries\varioscreen" "C:\Users\damir\AppData\Local\Temp\arduino_build_833406\sketch\variometer.ino.cpp" -o "nul"
"C:\Program Files (x86)\Arduino\hardware\tools\avr/bin/avr-g++" -c -g -Os -w -std=gnu++11 -fpermissive -fno-exceptions -ffunction-sections -fdata-sections -fno-threadsafe-statics  -flto -w -x c++ -E -CC -mmcu=atmega328p -DF_CPU=16000000L -DARDUINO=10612 -DARDUINO_AVR_PRO -DARDUINO_ARCH_AVR   "-IC:\Users\damir\AppData\Local\Arduino15\packages\arduino\hardware\avr\1.6.20\cores\arduino" "-IC:\Users\damir\AppData\Local\Arduino15\packages\arduino\hardware\avr\1.6.20\variants\eightanaloginputs" "-IC:\Users\damir\AppData\Local\Arduino15\packages\arduino\hardware\avr\1.6.20\libraries\SPI\src" "-IC:\Users\damir\Documents\Arduino\libraries\VarioSettings" "-IC:\Users\damir\Documents\Arduino\libraries\I2CDev_ms5611" "-IC:\Users\damir\Documents\Arduino\libraries\ms5611" "-IC:\Users\damir\Documents\Arduino\libraries\vertaccel" "-IC:\Users\damir\Documents\Arduino\libraries\LightInvensense" "-IC:\Users\damir\AppData\Local\Arduino15\packages\arduino\hardware\avr\1.6.20\libraries\EEPROM\src" "-IC:\Users\damir\Documents\Arduino\libraries\kalmanvert" "-IC:\Users\damir\Documents\Arduino\libraries\beeper" "-IC:\Users\damir\Documents\Arduino\libraries\LPtoneAC" "-IC:\Users\damir\Documents\Arduino\libraries\varioscreen" "-IC:\Users\damir\Documents\Arduino\libraries\digit" "C:\Users\damir\AppData\Local\Temp\arduino_build_833406\sketch\variometer.ino.cpp" -o "nul"
"C:\Program Files (x86)\Arduino\hardware\tools\avr/bin/avr-g++" -c -g -Os -w -std=gnu++11 -fpermissive -fno-exceptions -ffunction-sections -fdata-sections -fno-threadsafe-statics  -flto -w -x c++ -E -CC -mmcu=atmega328p -DF_CPU=16000000L -DARDUINO=10612 -DARDUINO_AVR_PRO -DARDUINO_ARCH_AVR   "-IC:\Users\damir\AppData\Local\Arduino15\packages\arduino\hardware\avr\1.6.20\cores\arduino" "-IC:\Users\damir\AppData\Local\Arduino15\packages\arduino\hardware\avr\1.6.20\variants\eightanaloginputs" "-IC:\Users\damir\AppData\Local\Arduino15\packages\arduino\hardware\avr\1.6.20\libraries\SPI\src" "-IC:\Users\damir\Documents\Arduino\libraries\VarioSettings" "-IC:\Users\damir\Documents\Arduino\libraries\I2CDev_ms5611" "-IC:\Users\damir\Documents\Arduino\libraries\ms5611" "-IC:\Users\damir\Documents\Arduino\libraries\vertaccel" "-IC:\Users\damir\Documents\Arduino\libraries\LightInvensense" "-IC:\Users\damir\AppData\Local\Arduino15\packages\arduino\hardware\avr\1.6.20\libraries\EEPROM\src" "-IC:\Users\damir\Documents\Arduino\libraries\kalmanvert" "-IC:\Users\damir\Documents\Arduino\libraries\beeper" "-IC:\Users\damir\Documents\Arduino\libraries\LPtoneAC" "-IC:\Users\damir\Documents\Arduino\libraries\varioscreen" "-IC:\Users\damir\Documents\Arduino\libraries\digit" "C:\Users\damir\AppData\Local\Temp\arduino_build_833406\sketch\NmeaParser.cpp" -o "nul"
"C:\Program Files (x86)\Arduino\hardware\tools\avr/bin/avr-g++" -c -g -Os -w -std=gnu++11 -fpermissive -fno-exceptions -ffunction-sections -fdata-sections -fno-threadsafe-statics  -flto -w -x c++ -E -CC -mmcu=atmega328p -DF_CPU=16000000L -DARDUINO=10612 -DARDUINO_AVR_PRO -DARDUINO_ARCH_AVR   "-IC:\Users\damir\AppData\Local\Arduino15\packages\arduino\hardware\avr\1.6.20\cores\arduino" "-IC:\Users\damir\AppData\Local\Arduino15\packages\arduino\hardware\avr\1.6.20\variants\eightanaloginputs" "-IC:\Users\damir\AppData\Local\Arduino15\packages\arduino\hardware\avr\1.6.20\libraries\SPI\src" "-IC:\Users\damir\Documents\Arduino\libraries\VarioSettings" "-IC:\Users\damir\Documents\Arduino\libraries\I2CDev_ms5611" "-IC:\Users\damir\Documents\Arduino\libraries\ms5611" "-IC:\Users\damir\Documents\Arduino\libraries\vertaccel" "-IC:\Users\damir\Documents\Arduino\libraries\LightInvensense" "-IC:\Users\damir\AppData\Local\Arduino15\packages\arduino\hardware\avr\1.6.20\libraries\EEPROM\src" "-IC:\Users\damir\Documents\Arduino\libraries\kalmanvert" "-IC:\Users\damir\Documents\Arduino\libraries\beeper" "-IC:\Users\damir\Documents\Arduino\libraries\LPtoneAC" "-IC:\Users\damir\Documents\Arduino\libraries\varioscreen" "-IC:\Users\damir\Documents\Arduino\libraries\digit" "-IC:\Users\damir\Documents\Arduino\libraries\NmeaParser" "C:\Users\damir\AppData\Local\Temp\arduino_build_833406\sketch\NmeaParser.cpp" -o "nul"
"C:\Program Files (x86)\Arduino\hardware\tools\avr/bin/avr-g++" -c -g -Os -w -std=gnu++11 -fpermissive -fno-exceptions -ffunction-sections -fdata-sections -fno-threadsafe-statics  -flto -w -x c++ -E -CC -mmcu=atmega328p -DF_CPU=16000000L -DARDUINO=10612 -DARDUINO_AVR_PRO -DARDUINO_ARCH_AVR   "-IC:\Users\damir\AppData\Local\Arduino15\packages\arduino\hardware\avr\1.6.20\cores\arduino" "-IC:\Users\damir\AppData\Local\Arduino15\packages\arduino\hardware\avr\1.6.20\variants\eightanaloginputs" "-IC:\Users\damir\AppData\Local\Arduino15\packages\arduino\hardware\avr\1.6.20\libraries\SPI\src" "-IC:\Users\damir\Documents\Arduino\libraries\VarioSettings" "-IC:\Users\damir\Documents\Arduino\libraries\I2CDev_ms5611" "-IC:\Users\damir\Documents\Arduino\libraries\ms5611" "-IC:\Users\damir\Documents\Arduino\libraries\vertaccel" "-IC:\Users\damir\Documents\Arduino\libraries\LightInvensense" "-IC:\Users\damir\AppData\Local\Arduino15\packages\arduino\hardware\avr\1.6.20\libraries\EEPROM\src" "-IC:\Users\damir\Documents\Arduino\libraries\kalmanvert" "-IC:\Users\damir\Documents\Arduino\libraries\beeper" "-IC:\Users\damir\Documents\Arduino\libraries\LPtoneAC" "-IC:\Users\damir\Documents\Arduino\libraries\varioscreen" "-IC:\Users\damir\Documents\Arduino\libraries\digit" "-IC:\Users\damir\Documents\Arduino\libraries\NmeaParser" "C:\Users\damir\AppData\Local\Arduino15\packages\arduino\hardware\avr\1.6.20\libraries\SPI\src\SPI.cpp" -o "nul"
"C:\Program Files (x86)\Arduino\hardware\tools\avr/bin/avr-g++" -c -g -Os -w -std=gnu++11 -fpermissive -fno-exceptions -ffunction-sections -fdata-sections -fno-threadsafe-statics  -flto -w -x c++ -E -CC -mmcu=atmega328p -DF_CPU=16000000L -DARDUINO=10612 -DARDUINO_AVR_PRO -DARDUINO_ARCH_AVR   "-IC:\Users\damir\AppData\Local\Arduino15\packages\arduino\hardware\avr\1.6.20\cores\arduino" "-IC:\Users\damir\AppData\Local\Arduino15\packages\arduino\hardware\avr\1.6.20\variants\eightanaloginputs" "-IC:\Users\damir\AppData\Local\Arduino15\packages\arduino\hardware\avr\1.6.20\libraries\SPI\src" "-IC:\Users\damir\Documents\Arduino\libraries\VarioSettings" "-IC:\Users\damir\Documents\Arduino\libraries\I2CDev_ms5611" "-IC:\Users\damir\Documents\Arduino\libraries\ms5611" "-IC:\Users\damir\Documents\Arduino\libraries\vertaccel" "-IC:\Users\damir\Documents\Arduino\libraries\LightInvensense" "-IC:\Users\damir\AppData\Local\Arduino15\packages\arduino\hardware\avr\1.6.20\libraries\EEPROM\src" "-IC:\Users\damir\Documents\Arduino\libraries\kalmanvert" "-IC:\Users\damir\Documents\Arduino\libraries\beeper" "-IC:\Users\damir\Documents\Arduino\libraries\LPtoneAC" "-IC:\Users\damir\Documents\Arduino\libraries\varioscreen" "-IC:\Users\damir\Documents\Arduino\libraries\digit" "-IC:\Users\damir\Documents\Arduino\libraries\NmeaParser" "C:\Users\damir\Documents\Arduino\libraries\I2CDev_ms5611\I2Cdev.cpp" -o "nul"
"C:\Program Files (x86)\Arduino\hardware\tools\avr/bin/avr-g++" -c -g -Os -w -std=gnu++11 -fpermissive -fno-exceptions -ffunction-sections -fdata-sections -fno-threadsafe-statics  -flto -w -x c++ -E -CC -mmcu=atmega328p -DF_CPU=16000000L -DARDUINO=10612 -DARDUINO_AVR_PRO -DARDUINO_ARCH_AVR   "-IC:\Users\damir\AppData\Local\Arduino15\packages\arduino\hardware\avr\1.6.20\cores\arduino" "-IC:\Users\damir\AppData\Local\Arduino15\packages\arduino\hardware\avr\1.6.20\variants\eightanaloginputs" "-IC:\Users\damir\AppData\Local\Arduino15\packages\arduino\hardware\avr\1.6.20\libraries\SPI\src" "-IC:\Users\damir\Documents\Arduino\libraries\VarioSettings" "-IC:\Users\damir\Documents\Arduino\libraries\I2CDev_ms5611" "-IC:\Users\damir\Documents\Arduino\libraries\ms5611" "-IC:\Users\damir\Documents\Arduino\libraries\vertaccel" "-IC:\Users\damir\Documents\Arduino\libraries\LightInvensense" "-IC:\Users\damir\AppData\Local\Arduino15\packages\arduino\hardware\avr\1.6.20\libraries\EEPROM\src" "-IC:\Users\damir\Documents\Arduino\libraries\kalmanvert" "-IC:\Users\damir\Documents\Arduino\libraries\beeper" "-IC:\Users\damir\Documents\Arduino\libraries\LPtoneAC" "-IC:\Users\damir\Documents\Arduino\libraries\varioscreen" "-IC:\Users\damir\Documents\Arduino\libraries\digit" "-IC:\Users\damir\Documents\Arduino\libraries\NmeaParser" "C:\Users\damir\Documents\Arduino\libraries\ms5611\ms5611.cpp" -o "nul"
"C:\Program Files (x86)\Arduino\hardware\tools\avr/bin/avr-g++" -c -g -Os -w -std=gnu++11 -fpermissive -fno-exceptions -ffunction-sections -fdata-sections -fno-threadsafe-statics  -flto -w -x c++ -E -CC -mmcu=atmega328p -DF_CPU=16000000L -DARDUINO=10612 -DARDUINO_AVR_PRO -DARDUINO_ARCH_AVR   "-IC:\Users\damir\AppData\Local\Arduino15\packages\arduino\hardware\avr\1.6.20\cores\arduino" "-IC:\Users\damir\AppData\Local\Arduino15\packages\arduino\hardware\avr\1.6.20\variants\eightanaloginputs" "-IC:\Users\damir\AppData\Local\Arduino15\packages\arduino\hardware\avr\1.6.20\libraries\SPI\src" "-IC:\Users\damir\Documents\Arduino\libraries\VarioSettings" "-IC:\Users\damir\Documents\Arduino\libraries\I2CDev_ms5611" "-IC:\Users\damir\Documents\Arduino\libraries\ms5611" "-IC:\Users\damir\Documents\Arduino\libraries\vertaccel" "-IC:\Users\damir\Documents\Arduino\libraries\LightInvensense" "-IC:\Users\damir\AppData\Local\Arduino15\packages\arduino\hardware\avr\1.6.20\libraries\EEPROM\src" "-IC:\Users\damir\Documents\Arduino\libraries\kalmanvert" "-IC:\Users\damir\Documents\Arduino\libraries\beeper" "-IC:\Users\damir\Documents\Arduino\libraries\LPtoneAC" "-IC:\Users\damir\Documents\Arduino\libraries\varioscreen" "-IC:\Users\damir\Documents\Arduino\libraries\digit" "-IC:\Users\damir\Documents\Arduino\libraries\NmeaParser" "C:\Users\damir\Documents\Arduino\libraries\vertaccel\vertaccel.cpp" -o "nul"
"C:\Program Files (x86)\Arduino\hardware\tools\avr/bin/avr-g++" -c -g -Os -w -std=gnu++11 -fpermissive -fno-exceptions -ffunction-sections -fdata-sections -fno-threadsafe-statics  -flto -w -x c++ -E -CC -mmcu=atmega328p -DF_CPU=16000000L -DARDUINO=10612 -DARDUINO_AVR_PRO -DARDUINO_ARCH_AVR   "-IC:\Users\damir\AppData\Local\Arduino15\packages\arduino\hardware\avr\1.6.20\cores\arduino" "-IC:\Users\damir\AppData\Local\Arduino15\packages\arduino\hardware\avr\1.6.20\variants\eightanaloginputs" "-IC:\Users\damir\AppData\Local\Arduino15\packages\arduino\hardware\avr\1.6.20\libraries\SPI\src" "-IC:\Users\damir\Documents\Arduino\libraries\VarioSettings" "-IC:\Users\damir\Documents\Arduino\libraries\I2CDev_ms5611" "-IC:\Users\damir\Documents\Arduino\libraries\ms5611" "-IC:\Users\damir\Documents\Arduino\libraries\vertaccel" "-IC:\Users\damir\Documents\Arduino\libraries\LightInvensense" "-IC:\Users\damir\AppData\Local\Arduino15\packages\arduino\hardware\avr\1.6.20\libraries\EEPROM\src" "-IC:\Users\damir\Documents\Arduino\libraries\kalmanvert" "-IC:\Users\damir\Documents\Arduino\libraries\beeper" "-IC:\Users\damir\Documents\Arduino\libraries\LPtoneAC" "-IC:\Users\damir\Documents\Arduino\libraries\varioscreen" "-IC:\Users\damir\Documents\Arduino\libraries\digit" "-IC:\Users\damir\Documents\Arduino\libraries\NmeaParser" "C:\Users\damir\Documents\Arduino\libraries\LightInvensense\LightInvensense.cpp" -o "nul"
"C:\Program Files (x86)\Arduino\hardware\tools\avr/bin/avr-g++" -c -g -Os -w -std=gnu++11 -fpermissive -fno-exceptions -ffunction-sections -fdata-sections -fno-threadsafe-statics  -flto -w -x c++ -E -CC -mmcu=atmega328p -DF_CPU=16000000L -DARDUINO=10612 -DARDUINO_AVR_PRO -DARDUINO_ARCH_AVR   "-IC:\Users\damir\AppData\Local\Arduino15\packages\arduino\hardware\avr\1.6.20\cores\arduino" "-IC:\Users\damir\AppData\Local\Arduino15\packages\arduino\hardware\avr\1.6.20\variants\eightanaloginputs" "-IC:\Users\damir\AppData\Local\Arduino15\packages\arduino\hardware\avr\1.6.20\libraries\SPI\src" "-IC:\Users\damir\Documents\Arduino\libraries\VarioSettings" "-IC:\Users\damir\Documents\Arduino\libraries\I2CDev_ms5611" "-IC:\Users\damir\Documents\Arduino\libraries\ms5611" "-IC:\Users\damir\Documents\Arduino\libraries\vertaccel" "-IC:\Users\damir\Documents\Arduino\libraries\LightInvensense" "-IC:\Users\damir\AppData\Local\Arduino15\packages\arduino\hardware\avr\1.6.20\libraries\EEPROM\src" "-IC:\Users\damir\Documents\Arduino\libraries\kalmanvert" "-IC:\Users\damir\Documents\Arduino\libraries\beeper" "-IC:\Users\damir\Documents\Arduino\libraries\LPtoneAC" "-IC:\Users\damir\Documents\Arduino\libraries\varioscreen" "-IC:\Users\damir\Documents\Arduino\libraries\digit" "-IC:\Users\damir\Documents\Arduino\libraries\NmeaParser" "C:\Users\damir\Documents\Arduino\libraries\kalmanvert\kalmanvert.cpp" -o "nul"
"C:\Program Files (x86)\Arduino\hardware\tools\avr/bin/avr-g++" -c -g -Os -w -std=gnu++11 -fpermissive -fno-exceptions -ffunction-sections -fdata-sections -fno-threadsafe-statics  -flto -w -x c++ -E -CC -mmcu=atmega328p -DF_CPU=16000000L -DARDUINO=10612 -DARDUINO_AVR_PRO -DARDUINO_ARCH_AVR   "-IC:\Users\damir\AppData\Local\Arduino15\packages\arduino\hardware\avr\1.6.20\cores\arduino" "-IC:\Users\damir\AppData\Local\Arduino15\packages\arduino\hardware\avr\1.6.20\variants\eightanaloginputs" "-IC:\Users\damir\AppData\Local\Arduino15\packages\arduino\hardware\avr\1.6.20\libraries\SPI\src" "-IC:\Users\damir\Documents\Arduino\libraries\VarioSettings" "-IC:\Users\damir\Documents\Arduino\libraries\I2CDev_ms5611" "-IC:\Users\damir\Documents\Arduino\libraries\ms5611" "-IC:\Users\damir\Documents\Arduino\libraries\vertaccel" "-IC:\Users\damir\Documents\Arduino\libraries\LightInvensense" "-IC:\Users\damir\AppData\Local\Arduino15\packages\arduino\hardware\avr\1.6.20\libraries\EEPROM\src" "-IC:\Users\damir\Documents\Arduino\libraries\kalmanvert" "-IC:\Users\damir\Documents\Arduino\libraries\beeper" "-IC:\Users\damir\Documents\Arduino\libraries\LPtoneAC" "-IC:\Users\damir\Documents\Arduino\libraries\varioscreen" "-IC:\Users\damir\Documents\Arduino\libraries\digit" "-IC:\Users\damir\Documents\Arduino\libraries\NmeaParser" "C:\Users\damir\Documents\Arduino\libraries\beeper\beeper.cpp" -o "nul"
"C:\Program Files (x86)\Arduino\hardware\tools\avr/bin/avr-g++" -c -g -Os -w -std=gnu++11 -fpermissive -fno-exceptions -ffunction-sections -fdata-sections -fno-threadsafe-statics  -flto -w -x c++ -E -CC -mmcu=atmega328p -DF_CPU=16000000L -DARDUINO=10612 -DARDUINO_AVR_PRO -DARDUINO_ARCH_AVR   "-IC:\Users\damir\AppData\Local\Arduino15\packages\arduino\hardware\avr\1.6.20\cores\arduino" "-IC:\Users\damir\AppData\Local\Arduino15\packages\arduino\hardware\avr\1.6.20\variants\eightanaloginputs" "-IC:\Users\damir\AppData\Local\Arduino15\packages\arduino\hardware\avr\1.6.20\libraries\SPI\src" "-IC:\Users\damir\Documents\Arduino\libraries\VarioSettings" "-IC:\Users\damir\Documents\Arduino\libraries\I2CDev_ms5611" "-IC:\Users\damir\Documents\Arduino\libraries\ms5611" "-IC:\Users\damir\Documents\Arduino\libraries\vertaccel" "-IC:\Users\damir\Documents\Arduino\libraries\LightInvensense" "-IC:\Users\damir\AppData\Local\Arduino15\packages\arduino\hardware\avr\1.6.20\libraries\EEPROM\src" "-IC:\Users\damir\Documents\Arduino\libraries\kalmanvert" "-IC:\Users\damir\Documents\Arduino\libraries\beeper" "-IC:\Users\damir\Documents\Arduino\libraries\LPtoneAC" "-IC:\Users\damir\Documents\Arduino\libraries\varioscreen" "-IC:\Users\damir\Documents\Arduino\libraries\digit" "-IC:\Users\damir\Documents\Arduino\libraries\NmeaParser" "C:\Users\damir\Documents\Arduino\libraries\LPtoneAC\toneAC.cpp" -o "nul"
"C:\Program Files (x86)\Arduino\hardware\tools\avr/bin/avr-g++" -c -g -Os -w -std=gnu++11 -fpermissive -fno-exceptions -ffunction-sections -fdata-sections -fno-threadsafe-statics  -flto -w -x c++ -E -CC -mmcu=atmega328p -DF_CPU=16000000L -DARDUINO=10612 -DARDUINO_AVR_PRO -DARDUINO_ARCH_AVR   "-IC:\Users\damir\AppData\Local\Arduino15\packages\arduino\hardware\avr\1.6.20\cores\arduino" "-IC:\Users\damir\AppData\Local\Arduino15\packages\arduino\hardware\avr\1.6.20\variants\eightanaloginputs" "-IC:\Users\damir\AppData\Local\Arduino15\packages\arduino\hardware\avr\1.6.20\libraries\SPI\src" "-IC:\Users\damir\Documents\Arduino\libraries\VarioSettings" "-IC:\Users\damir\Documents\Arduino\libraries\I2CDev_ms5611"
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

Thread 16 (2018-01-29):

No conection with gps neo m8n

damirm57, 2018-01-29:
Hi, one more question. I have gps ublox neo m8n conected to vario, but i can not see any update only stay km/h without 0 or any number, Do I need some extra settings with ublox centar before conect to vario? On ublox centar gps funktion is OK.

jpg63, 2018-01-29:
For the neo-8m the NMEA header is different a modification of the code of the library serialnmea.cpp #if defined (VARIOMETER_GPS_NEO6) const char rmcTag [] PROGMEM = {"GPRMC"}; const char ggaTag [] PROGMEM = {"GPGGA"}; #elif defined (VARIOMETER_GPS_NEO8) const char rmcTag [] PROGMEM = {"GNRMC"}; const char ggaTag [] PROGMEM = {"GNGGA"}; #else const char rmcTag [] PROGMEM = {"GPRMC"}; const char ggaTag [] PROGMEM = {"GPGGA"}; #endif must allow to operate the 2 GPS

________________________________
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

damirm57, 2018-01-30:
Thank you for fast answer. I am try to integrate changes in code but obviousli in wrong way. Becose i how no exsperience in programing. When try to verify ino error message is:

C:\Program Files (x86)\Arduino\libraries\SerialNmea\SerialNmea.cpp:5:37: error: missing binary operator before token "const"

prunkdump, 2018-01-30:
Hi Damir.

Take the original code and just change the libraries/SerialNmea/SerialNmea.cpp from :

const char rmcTag[] PROGMEM = {"GPRMC"};
const char ggaTag[] PROGMEM = {"GPGGA"};

To

const char rmcTag[] PROGMEM = {"GNRMC"};
const char ggaTag[] PROGMEM = {"GNGGA"};

And it's ok.

Regards,

Baptiste.

damirm57, 2018-01-30:
Awesome,  gps fix is done. Thanks Baptiste, fantastic project. I am
begginer in paragliding, thank you, thank you!!!!
Is it posibile  to conect aditional board mpu9250 without ms5611(this is
already conected) I have one more rest  from Ed tracker project.

2018-01-30 19:24 GMT+01:00 prunkdump <notifications@github.com>:

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

jpg63, 2018-01-30:
I added the management of the neo-8m GPS in the branch jpg63-version on the github

the choice between neo-6 and neo-8 is done in the file variosettings.h

jean-philippe

________________________________
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

prunkdump, 2018-01-31:
Good news !

Yes Damir you can connect your mpu9250 board on the same pins (A4 and A5).

If it don't works, add :
-> one 4,7k resistor between A4 and 3.3V
-> one 4,7k resistor between A5 and 3.3V

Regards,

Baptiste.

damirm57, 2018-01-31:
Thank you again!

2018-01-31 7:13 GMT+01:00 prunkdump <notifications@github.com>:

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

prunkdump, 2019-04-27:
It's now possible to correct this in VarioSettings.h

Thanks for the report.

Closed 2019-04-27.

Thread 17 (2018-05-27):

Suggestion: Beeper shouldn't beep as soon as climb rate changes

lshachar, 2018-05-27:
Hey,
I wonder if this is upsetting to anyone else except me;
whenever your climb rate changes, a new beep sound plays through the speaker, overriding the break you would normally get between two consecutive beeps in other varios.
I find it distracting, and I think of it as a bug.

Furthermore, I like the audio control you get with[ this editor tool, ](http://www.windeckfalken.de/special/xctracer/handson/main.html)
and I also like how the pitch changes smoothly while playing notes (as can be heard in the editor tool), I find it to be more informative.
I intend to rewrite some of the sound module... who knows when...

prunkdump, 2018-06-01:
Hi lshachar !

I don't notice the bug you report. Sometimes you get two consecutive beeps without break between them ? The only case where this append to me is when you enter/go out/enter the climbing zone in a very short time. This should not append often in real conditions.

But I'am not sure I correctly understand your remark.

Also, I have made a tool to setup the beeps.

-> Download Geogebra here (v5 classic)
https://www.geogebra.org

-> Open this file with geogebra
http://www.parapentiste.info/forum/index.php?action=dlattach;topic=48334.0;attach=32689

-> Change beeper.h

Regards,

Baptiste.

prunkdump, 2018-06-01:
Excuse this is the correct file :
http://www.parapentiste.info/forum/index.php?action=dlattach;topic=48334.0;attach=32696

lshachar, 2018-07-17:
Thank you!

Closed 2020-04-07.

Thread 19 (2018-07-23):

Cannot calibrate accelerometer (MPU6050) at all?

lshachar, 2018-07-23:
Hey,
I'm trying to use accel_calibration sketch to calibrate my vario.
I followed the directions as closely as I could, mimicking every orientation by how it's portrayed on the calibration video on youtube, and by the same order.
after taking several 'm' measurements for each of the five orientations, when I couldn't get a lower standard deviation value, I sent 'c' to start calibration. unfortunately, the new calibration coefficients all come up as not available.

(I trimmed the information from the serial monitor, to only contain the best measurement from every orientation. I did not change the log order in any way. my notes are in **enclosure**.)

```
-------------------------
ACCELEROMETER CALIBRATION
-------------------------

Commands :
  d : display current accel vector
  m : measure accel vertor for calibration
  c : start calibration
  r : restart calibration to the beginning

Procedure :
  The accelerometer calibration procedure
  need five accel vectors from the five upper
  orientations. That is to say with the
  accelerometer pointing :
    -> toward the sky, flat on the groud
    -> toward the left on it's left side
    -> toward the right on it's right side
    -> toward you on it's bottom side
    -> back to you, on it's top side

  For each measure :
  1) You can check the current accel vector
     with multiple 'd' command.
  2) Record the accel vector with the 'm' command
     This can be done multiple times for each orientations

  Once the five orientations recorded. You can
  launch the calibration procedure with the 'c'
  command. Use the 'd' command  to check the result.
  The distance must be as close as possible to 1.000.
  If you are not satisfied by the result. Make more
  measures or reset teh calibration with the 'r' command.
Current calibration coefficients :
x : 0.00000
y : 0.00000
z : 0.00000

**1 FLAT ON GROUND**
-------------------------
Ready to make measure.
Don't move the accelerometer and wait...
Starting measure...
accel=(348.42666, -133.66999, 7786.48681)
Standard deviation = 51.96819
GOOD measure, recorded for calibration
-------------------------

**2 LEFT**
-------------------------
Ready to make measure.
Don't move the accelerometer and wait...
Starting measure...
accel=(-8086.21337, -105.69667, -132.12666)
Standard deviation = 54.61066
GOOD measure, recorded for calibration
-------------------------

**3 BOTTOM**
-------------------------
Ready to make measure.
Don't move the accelerometer and wait...
Starting measure...
accel=(-39.97666, -8213.40332, -266.01000)
Standard deviation = 54.84888
GOOD measure, recorded for calibration
-------------------------

**4 RIGHT**
-------------------------
Ready to make measure.
Don't move the accelerometer and wait...
Starting measure...
accel=(8298.42968, 142.45333, -505.80334)
Standard deviation = 54.18161
GOOD measure, recorded for calibration
-------------------------

**5 TOP**
-------------------------
Ready to make measure or calibration.
Don't move the accelerometer and wait...
Starting measure...
accel=(109.35334, 8180.58984, -327.39999)
Standard deviation = 54.46234
GOOD measure, recorded for calibration
-------------------------

**Result for sending 'c' :**
-------------------------
CALIBRATION DONE
-------------------------

Here the new calibration coefficients :

x : nan
y : nan
z : nan

Run multiple 'd' command to check the result.
-------------------------

**Result for sending 'd' :**
-------------------------
Ready to make measure or calibration.
Don't move the accelerometer and wait...
Starting measure...
accel=(nan, nan, nan)
Standard deviation = 56.19025
calibrated distance : nan
-------------------------
```

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

AvisParadocs, 2018-07-26:
+1
Same issue with mpu9250.
(#define IMU_CALIBRATION_IN_EEPROM is uncommented and static values is commented)

lshachar, 2018-07-26:
Hey AvisParadocs,
I just received an email from PrunkDump earlier today. for now, he recommends a workaround:
Do you have an SD card reader ? The problem you encounter is because I
recently changed the calibration procedure and not fully adapted the
previous sketch. If you can test :
-> connect an SD card reader
-> format an SD card with FAT16 (less than 2Go partition)
-> run the "calibration_recorder" sketch and records as many
orientations as possible ( I usually make 100 measures )
-> put the file recorded in "best-fit-calibration"
-> install Python 2
-> run the python program
-> copy the result in VarioSettings.h

(- i still haven't gotten around to try it)

prunkdump, 2018-07-26:
Hello.

I’am in vacations without computer so it’s not easy to debug the problem.

But I have found an error for sure. Maybe someone can try if it fixe the bug.

In libraries/AccelCalibrator/accelcalibrator.cpp

Change :

baseRadius /= (double)(3*ACCEL_CALIBRATOR_ORIENTATION_COUNT);

To

baseRadius /= (double)(ACCEL_CALIBRATOR_ORIENTATION_COUNT);

Maybe it will be fine after this.

Regards.

lshachar, 2018-07-26:
Tried it, didn't work :\
still haven't tried it with the SD card reader workaround

AvisParadocs, 2018-07-29:
Glad to hear it!
I'll prefer to use near climbing beeper instead of alarm, but in ground tests I didnt manage to see it working. At the moment trying to debug 10DOF sensor through serial port.
What was turbulence density in your test and how comfortable was vario sound in that conditions? I'm highly afraid that so high precise vario sensitivity can alarm climbing and sinking all over the place and especially in turbulence =)

lshachar, 2018-08-06:
I'm afraid calibration_recorder.ino will not build when MPU6050 or MPU6500 are defined, (will only build when MPU9150 or MPU9250 are defined)

error message:
`
calibration_recorder.ino: In function 'void makeMeasureStep()':
calibration_recorder:130: error: 'class Vertaccel' has no member named 'readRawMag'
class Vertaccel has no member named 'readRawMag'
`

lshachar, 2018-08-12:
I eventually got calibration_recorder to build (by adding  #ifdef AK89xx_SECONDARY  calibration_recorder line 129, which prevents the magnetometer readings)

and I was able to get real data from calibration_recorder. also later I installed python (you need 2.7, and install numpy library as well)

but eventually I found out that changing values in variosettings.h, such as IMU_ACCEL_CAL_BIAS, will not make any difference for the vario, since that value is not used anywhere in the program. It's one more thing that's not yet implemented.

prunkdump, 2018-08-13:
Hi !

I finally found the bug in the calibration code. Can you try again "accel_calibration" for me with the #define IMU_CALIBRATION_IN_EEPROM uncommented. And say me if it works.

@Ishachar. Good job ! For your problem, maybe you have forgotten to comment #define IMU_CALIBRATION_IN_EEPROM in VarioSettings.h. The constant IMU_ACCEL_CAL_BIAS is used in variometer.ino.

I will try to adapt my code when there is no magnetometer.

Regards,

Baptiste.

prunkdump, 2019-04-27:
I have modified the "calibration_recorder" sketch and the "calibrate.py" script to work with accelerometer without magnetometer.

Thanks for the report.

Closed 2019-04-27.

Thread 23 (2018-09-13):

#define MPU6050 causes a compiler error

Lion1971, 2018-09-13:
Hello,
if I use a MPU6050 by #define MPU6050 in the variosettings the compiler for the variometer.ino causes the following compiler error:

"C:\...\Arduino\libraries\vertaccel\vertaccel.cpp:333:1: error: expected '}' at end of input
 }
 ^
exit status 1"

If I define  a MPU9250 (which I don't have) it can be compiled.

In the old version of the JPG63 didn't have that issue.

Thank you and best regards
Lion

Lion1971, 2018-09-15:
Hello,
here is the result of another test. I changed in the variosettings.h the calibration method from "by static value" to "by EEPROM". Then the compiler message is the following.
Best regards
Lion

C:\...\arduino-variometer-jpg63-version\arduino-variometer-jpg63-version\variometer\variometer.ino:388:9: warning: extra tokens at end of #endif directive [-Wendif-labels]

  #endif HAVE_SCREEN_JPG63
         ^
C:\Users\...\Documents\Arduino\libraries\vertaccel\vertaccel.cpp: In member function 'uint8_t Vertaccel::dataReady()':

C:\Users\...\Documents\Arduino\libraries\vertaccel\vertaccel.cpp:222:33: error: qualified-id in declaration before '(' token

 uint8_t Vertaccel::dataFullReady(double* accel, double* quat, double* v, double* n) {
                                 ^
C:\Users\...\Documents\Arduino\libraries\vertaccel\vertaccel.cpp:333:1: error: expected '}' at end of input
 }
 ^

exit status 1

prunkdump, 2018-09-15:
Ok I'have updated the code.

Try if it's good now.

Lion1971, 2018-09-15:
Thank you Baptiste for your work :-)

The variometer.ino can be compiled with the following warning (see below), but is uploaded.
The only issue is now, that the vertical speed is around -1m/s also after a new calibartion. I tried calibration method "by EEPROM" and "by static". Before it was around 0m/s

Best regards
Lion

Compiler warnings:

#endif HAVE_SCREEN_JPG63
         ^
C:\Users\...\Documents\Arduino\libraries\varioscreen\varioscreen.cpp: In member function 'void ScreenScheduler::displayStep()':
C:\Users\...\Documents\Arduino\libraries\varioscreen\varioscreen.cpp:734:24: warning: passing 'const VarioScreen' as 'this' argument discards qualifiers [-fpermissive]
   if( screen.clearStep() ) {
                        ^
C:\Users\...\Documents\Arduino\libraries\varioscreen\varioscreen.cpp:224:6: note:   in call to 'bool VarioScreen::clearStep()'
 bool VarioScreen::clearStep() {
      ^
C:\Users\...\Documents\Arduino\libraries\varioscreen\varioscreen.cpp: In member function 'void ScreenScheduler::setPage(int8_t)':
C:\Users\...\Documents\Arduino\libraries\varioscreen\varioscreen.cpp:773:21: warning: passing 'const VarioScreen' as 'this' argument discards qualifiers [-fpermissive]
   screen.beginClear();
                     ^
C:\Users\...\Documents\Arduino\libraries\varioscreen\varioscreen.cpp:220:6: note:   in call to 'void VarioScreen::beginClear()'
 void VarioScreen::beginClear() {
      ^

Lion1971, 2018-09-15:
Sorry I pushed the wrong buttom (Close).

prunkdump, 2018-09-16:
Hi Lion.

You see -1.0m/s on the screen ?! Or just -0.1m/s ?

First to be sure.
-> Move all files in your "Arduino" folder in some backup place.
-> Download the latest "master" branch code
https://github.com/prunkdump/arduino-variometer/archive/master.zip
-> copy the content of the arduino-variometer-master folder inside your arduino folder
-> Change only in VarioSettings.h : the MPU and your pins

Compile and upload. And check the result. Say me what you se in the screen.

Regards,

Baptiste.

Lion1971, 2018-09-16:
Hi Baptiste,

I downloaded the master like you suggested instead of the JPG63 and the result is the same, but no compiler warnings.
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
 When the vario is laying on the table the value differs between -1,0m/s and -1,1m/s.

Regards
Lion

prunkdump, 2018-09-16:
Ok this is a bug. Not a calibration problem.

Can you enable the « calibration in EEPROM » and run the accel_calibration sketch ?

Or the calibration_recorder sketch if you have a working SD card.

I just need one raw measure of your accelerometer.

If you run the accel_calibration sketch send me one measure output.

If you run the calibration_recorder sketch send me the file recoded on the SD card.

Regards,

Baptiste.

prunkdump, 2018-09-17:
Thanks.

Last question. When you upload the master version with all the default parameters.
-> You have -1.0m/s when the variometer is flat on the table

But what do you have if you put the screen toward the ground ?
-> -1.0m/s
or
-> 1.0 m/s
??

Can you also make the full calibration procedure with "accel_calibration" and send to me the full serial output.

Regards,

Baptiste.

Lion1971, 2018-09-17:
Before I send a wrong input.

From the masters default settings I changed the MPU from 9250 to 6050 or should I try 9250 even if I have the 6050 HW?

The full calibration should be done with the "m" command at the seriel console?

Regards
Lion

prunkdump, 2018-09-17:
Excuse me.

Yes you set mpu6050.

And for the full calibration :
-> you set calibration in eeprom
-> you upload "accel_calibration"
-> you make an "m" command for each orientation
-> you start calibration with the "c" command
-> you send to me the full console Serial Log.

Regards,

Baptiste.

Lion1971, 2018-09-17:
Here are the answer and result of the tests I did.

Flat on the table it is -1,0m/s
If I put the screen toward the ground it shows +1,3m/s.

Result of the measures (2 values per orientation) and the calibration. I deleted some redundant lines with "Ready to ..."

-------------------------
Ready to make measure.
Don't move the accelerometer and wait...
Starting measure...
accel=(906.69000, -682.41998, 7141.47656)
Standard deviation = 81.15827
GOOD measure, recorded for calibration
-------------------------
Ready to make measure or calibration.
-------------------------
Ready to make measure or calibration.
Don't move the accelerometer and wait...
Starting measure...
accel=(872.59997, -730.93664, 7140.11328)
Standard deviation = 74.12198
GOOD measure, recorded for calibration
-------------------------
Ready to make measure or calibration.
-------------------------
Ready to make measure or calibration.
Don't move the accelerometer and wait...
Starting measure...
accel=(40.52667, 8027.25000, -181.44000)
Standard deviation = 71.99639
GOOD measure, recorded for calibration
-------------------------
Ready to make measure or calibration.
-------------------------
Ready to make measure or calibration.
Don't move the accelerometer and wait...
Starting measure...
accel=(42.70333, 8024.37988, -140.61666)
Standard deviation = 74.07876
BAD measure, not recorded, possible problems are :
-> ambiguous orientation
-> orientation already done with lower standard deviation
-------------------------
Ready to make measure or calibration.
-------------------------
Ready to make measure or calibration.
Don't move the accelerometer and wait...
Starting measure...
accel=(8578.80371, -250.69332, -1371.96667)
Standard deviation = 78.79714
GOOD measure, recorded for calibration
-------------------------
Ready to make measure or calibration.
-------------------------
Ready to make measure or calibration.
Don't move the accelerometer and wait...
Starting measure...
accel=(8580.21679, -253.15666, -1350.05004)
Standard deviation = 72.09682
GOOD measure, recorded for calibration
-------------------------
Ready to make measure or calibration.
-------------------------
Ready to make measure or calibration.
Don't move the accelerometer and wait...
Starting measure...
accel=(699.50335, -8376.92968, -1594.63000)
Standard deviation = 66.59497
GOOD measure, recorded for calibration
-------------------------
Ready to make measure or calibration.
-------------------------
Ready to make measure or calibration.
Don't move the accelerometer and wait...
Starting measure...
accel=(707.22332, -8380.69042, -1473.22338)
Standard deviation = 62.68950
GOOD measure, recorded for calibration
-------------------------
Ready to make measure or calibration.
-------------------------
Ready to make measure or calibration.
Don't move the accelerometer and wait...
Starting measure...
accel=(-7836.50976, -342.60998, -730.08666)
Standard deviation = 67.58684
GOOD measure, recorded for calibration
-------------------------
Ready to make measure or calibration.
-------------------------
Ready to make measure or calibration.
Don't move the accelerometer and wait...
Starting measure...
accel=(-7840.72998, -62.40000, -773.97668)
Standard deviation = 64.91309
GOOD measure, recorded for calibration
-------------------------
Ready to make measure or calibration.
-------------------------
CALIBRATION DONE
-------------------------

Here the new calibration coefficients :

x : 354.71286
y : -167.63986
z : -1055.46362

Run multiple 'd' command to check the result.
-------------------------
-------------------------
Ready to make measure or calibration.
-------------------------

Best regards
Lion

prunkdump, 2018-09-17:
Thanks !

Comment now the calibration in EEPROM en VarioSettings.h. And set this static value :

#define IMU_ACCEL_CAL_BIAS {23696, -10224, -67324}

Say me if this correct your problem before investigating further.

Baptiste.

Lion1971, 2018-09-17:
The value is the same -1,0m/s

The compile shows the following warning:

D:\...\arduino-variometer-master\arduino-variometer-master\variometer\variometer.ino:61:1: warning: narrowing conversion of '-67324l' from 'long int' to 'int16_t {aka int}' inside { } [-Wnarrowing]
 };
 ^
D:\...\arduino-variometer-master\arduino-variometer-master\variometer\variometer.ino:61:1: warning: overflow in implicit constant conversion [-Woverflow]

Regards Lion

prunkdump, 2018-09-17:
So I understand the problem !

Your mpu need a very high calibration coefficient. And this overflow the 16bit variable containing it.

Are you sure there is not something that apply pressure on you mpu chip ? It give very faulty values.

But I have a workaround method.
In libraries/vertaccel/vertaccel.h change :

#define VERTACCEL_ACCEL_CAL_BIAS_MULTIPLIER 4

And in variosettings. Divide all the bias coefficient by 4 ( take the nearest integer ).

Lion1971, 2018-09-17:
Thank You Bapiste for the great support, the workaround is fine and now it is around 0m/s

Because I have two devices and both worked with the old version of the JPG63 I have some questions:

1. What was different in the old version and are there advantages in the new version that I should update?

2. Because two independent MPU6050 devices have the problem shouldn't this workaround be the standard in the new version?

3. Can I do the accel_calibration_nointeractive and use the EEPROM also with the workaround?

4. When I like to use the new JPG63 version I have to transfer the workaround from the master to the JPG63 version, right?

Regards Lion

Lion1971, 2018-09-18:
Thank you I will test and send the result this evening.

For 1) Do I have an advantage with magnetometer? Means a new feature now or in the future?

Which MPU type is your recommendation 9050, 9250...? They are not expensive to exchange.

Regards Lion

prunkdump, 2018-09-18:
Actually the magnetometer is functional but not used. It's for the future (compas, compute wind speed ...)

My recommendation is MPU9250. You can find it already coupled with the ms5611.

Thanks for the tests.

Regards.

Baptiste.

Lion1971, 2018-09-18:
Hi!
the workaround works also with the new JPG63 version with accel_calibration_nointeractive and usage of the EEPROM. Thank you so much :+1:

The only issue what appears again during the compilation are the following warnings regarding the varioscreen. I don't know if it is a serious problem or it can be irgnored? The screen shows normal values.

Best regards
Lion

D:\...\arduino-variometer-jpg63-version\arduino-variometer-jpg63-version\variometer\variometer.ino:388:9: warning: extra tokens at end of #endif directive [-Wendif-labels]

  #endif HAVE_SCREEN_JPG63
         ^
C:\Users\...\Documents\Arduino\libraries\varioscreen\varioscreen.cpp: In member function 'void ScreenScheduler::displayStep()':
C:\Users\...\Documents\Arduino\libraries\varioscreen\varioscreen.cpp:734:24: warning: passing 'const VarioScreen' as 'this' argument discards qualifiers [-fpermissive]
   if( screen.clearStep() ) {
                        ^
C:\Users\...\Documents\Arduino\libraries\varioscreen\varioscreen.cpp:224:6: note:   in call to 'bool VarioScreen::clearStep()'
 bool VarioScreen::clearStep() {
      ^
C:\Users\...\Documents\Arduino\libraries\varioscreen\varioscreen.cpp: In member function 'void ScreenScheduler::setPage(int8_t)':
C:\Users\...\Documents\Arduino\libraries\varioscreen\varioscreen.cpp:773:21: warning: passing 'const VarioScreen' as 'this' argument discards qualifiers [-fpermissive]
   screen.beginClear();
                     ^
C:\Users\...\Documents\Arduino\libraries\varioscreen\varioscreen.cpp:220:6: note:   in call to 'void VarioScreen::beginClear()'
 void VarioScreen::beginCl_ear() {
      ^

prunkdump, 2018-09-18:
Perfect !

Thanks you for investigating the problem.

I close the issue. If you want to contact me. You can use my email on my profile.

Regards,

Baptiste.

Closed 2018-09-18.

Thread 24 (2018-11-19):

Outdated Readme

Hasi123, 2018-11-19:
Hi, please update the readme file. There is no documentation on how to calibrate the magnetometer without an SD card. I tried to update my simple vario with the BMP280/MPU9250 with your latest updates, but it didn't work.

Does the magnetometer make any real-world difference?

prunkdump, 2018-11-22:
Hi !

You're right ! But as the magnetometer is not really used actually, I don't have taken the time to update the README.

The target feature is wind speed/direction detection.

To use the calibratiion sketch move the variometer in many directions. Each time you have a new direction you have a beep. When there is to much time without new direction recorded the variometer make three beeps signaling that the calibration is done.

I keep your issue.

Thread 26 (2018-11-28):

Issue after HW upgrade to NEO6MV2 and 10DOF (5611/9250)

LL03, 2018-11-28:
Hello,
I replaced my old GPS module by the blue NEO6MV2 and the 10DOF sensor whith combined MS5611 and MPU9250. Before it was the red NEO6M and the MS5611 and MPU9250 separate.
I am using the jpg63 software. With the new software the display starts blinking after around 30s and is frozen and no sound. Then it restarts and it could also happen that the display is mixed up and there is a continous sound before it restarts again.

The display is OK
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
The display is mixed up and the attitude changes to baro value. After the automatic restart it is like the first picture again.
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

I read the issue "Using a NEO6MV2 (XM37-1612) , old GPS" and changed the NMEA_Parser settings and the restart problem is solved but the shown valeus for the time and attitude are wrong.

//#define NMEA_PARSER_RMC_SPEED_PRECISION 1000.0
//#define NMEA_PARSER_GGA_TIME_PRECISION 100
//#define NMEA_PARSER_GGA_ALTITUDE_PRECISION 10.0
#define NMEA_PARSER_RMC_SPEED_PRECISION 100 // initialement 1000.0
#define NMEA_PARSER_GGA_TIME_PRECISION 1000   //initialement  100
#define NMEA_PARSER_GGA_ALTITUDE_PRECISION 100.0  //initialement  10.0

What is the meaning of the parameters and what are valid values. Which can I use that the values are correct but my restart problem is further solved?

Best regards
LL03

LL03, 2018-11-28:
So I did another test an removed the TX line from the GPS. It remains the same issue, that I now think it is the 10DOF sensor whith combined MS5611 and MPU9250 (purple version). Could it happen if the 10DOF is not delivering correct or constantly values? I build two devices and the behaviour is the same.

prunkdump, 2018-11-28:
Hi LL03 !

The problem you describe seems to be a powering problem.

When you power-on your variometer something need to much current that you power circuit can't feed. So the voltage decrease greatly and the ms5611 ( very sensitive to power ) give bad values. This is because your screen display too big numbers.

Sometimes the voltage decrease so much that is goes under the Arduino brown out detection. So a reset is launched and the Arduino reboot.

How do you power your components ? Have you changed some voltage regulators ?

The "blue" neo-6M does not not need code modification. You can keep the original code. But it need power as it is a little hungry ;)

Regards,

Baptiste.

LL03, 2018-11-28:
Hi Baptiste,
I will measure the overall current. I have a Lipo as power supply all componeents are directly connected to the Lipo except the Display and MicroSD card reader, but without SD card in it. They are connected to VCC (3.3V). I will desolder the reader.
Thank you I will inform you.
Regards
LL03

LL03, 2018-11-28:
Hi Baptiste,
I measured the current an it is around 100mA and the card reader alone without SD Card only some mA. But without the card reader the vario works. I assume that the connected signal pins are the root cause.
Do you recommend a specific micro SD card reader and can I use a 3.3V type?
I think the issue can be closed.
Regards
LL03

LL03, 2018-11-28:
Hi Baptiste,
the Lipo has 1000mA and the voltage at the supply pins is 3,8V. I desoldered the reader an now it works. Then I used a different microSD reader type, also with 3,3V and it works too without reset. Now it can also write IGC files. So I will replace the modules. For the support two pictures. The 1st which works fine and the 2nd which is not usable.
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
Regards
LL03

prunkdump, 2018-11-29:
Thanks for your feedback !

But I think your previous SD card module have a problem. Some short circuit maybe.

i use the same module than you :

https://prunkdump.github.io/GNUVario/tutorials/boards.html

Regards,

Baptiste.

prunkdump, 2018-11-29:
I close the issue.

LL03, 2018-12-03:
Many thanks for the support:-)
Can I ask a question or should I open a new topic?
With the other module (which you use) I have the reset problem sometimes too without SD  Card in the slot.
When I solder a SD module and configure "Have SD card", is it mandatory to plug in a SD card?
If this configuration causes problems, can I solve it by a configuration change: Deactivate "Have SD card"?
If that is the case can the programm be more tolerant if an SD card is not available?
Best regards
LL03

prunkdump, 2018-12-17:
Someone give the solution to me !

Simply put a wire between the IMU AD0 pin and ground (GND) !

I think this will solve your issue !

Regards,

Baptiste

Closed 2018-11-29.

Thread 35 (2019-09-24):

Not compiling

linwp, 2019-09-24:
Hi. I simply cloned the repo to my Arduino directory. Copied the libraries to the libraries folder and the variometer.ino and some other sketches will not compile.
Can you confirm this?
I'm using Arduino IDE 1.8.9

Compiler output looks like this:

`Arduino: 1.8.9 (Linux), Board: "Arduino Pro or Pro Mini, ATmega328 (5V, 16 MHz)"

/home/linwop/Arduino/libraries/Robot_Control/src/ArduinoRobot.cpp: In constructor 'RobotControl::RobotControl()':
/home/linwop/Arduino/libraries/Robot_Control/src/ArduinoRobot.cpp:26:42: error: 'LCD_CS' was not declared in this scope
 RobotControl::RobotControl():Arduino_LCD(LCD_CS,DC_LCD,RST_LCD){
                                          ^
/home/linwop/Arduino/libraries/Robot_Control/src/ArduinoRobot.cpp:26:49: error: 'DC_LCD' was not declared in this scope
 RobotControl::RobotControl():Arduino_LCD(LCD_CS,DC_LCD,RST_LCD){
                                                 ^
/home/linwop/Arduino/libraries/Robot_Control/src/ArduinoRobot.cpp:26:56: error: 'RST_LCD' was not declared in this scope
 RobotControl::RobotControl():Arduino_LCD(LCD_CS,DC_LCD,RST_LCD){
                                                        ^
/home/linwop/Arduino/libraries/Robot_Control/src/ArduinoRobot.cpp: In member function 'void RobotControl::begin()':
/home/linwop/Arduino/libraries/Robot_Control/src/ArduinoRobot.cpp:36:21: error: 'MUXA' was not declared in this scope
  uint8_t MuxPins[]={MUXA,MUXB,MUXC,MUXD};
                     ^
/home/linwop/Arduino/libraries/Robot_Control/src/ArduinoRobot.cpp:36:26: error: 'MUXB' was not declared in this scope
  uint8_t MuxPins[]={MUXA,MUXB,MUXC,MUXD};
                          ^
/home/linwop/Arduino/libraries/Robot_Control/src/ArduinoRobot.cpp:36:31: error: 'MUXC' was not declared in this scope
  uint8_t MuxPins[]={MUXA,MUXB,MUXC,MUXD};
                               ^
/home/linwop/Arduino/libraries/Robot_Control/src/ArduinoRobot.cpp:36:36: error: 'MUXD' was not declared in this scope
  uint8_t MuxPins[]={MUXA,MUXB,MUXC,MUXD};
                                    ^
/home/linwop/Arduino/libraries/Robot_Control/src/ArduinoRobot.cpp:37:29: error: 'MUX_IN' was not declared in this scope
  Multiplexer::begin(MuxPins,MUX_IN,4);
                             ^
/home/linwop/Arduino/libraries/Robot_Control/src/ArduinoRobot.cpp:40:10: error: 'BUZZ' was not declared in this scope
  pinMode(BUZZ,OUTPUT);
          ^
/home/linwop/Arduino/libraries/Robot_Control/src/ArduinoRobot.cpp:43:2: error: 'Serial1' was not declared in this scope
  Serial1.begin(9600);
  ^
Multiple libraries were found for "SdCard.h"
 Used: /home/linwop/Arduino/libraries/Robot_Control
 Not used: /home/linwop/Arduino/libraries/LightFat16
 Not used: /home/linwop/Arduino/libraries/LightFat16
 Not used: /home/linwop/Arduino/libraries/LightFat16
 Not used: /home/linwop/Arduino/libraries/LightFat16
/home/linwop/Arduino/libraries/Robot_Control/src/Sensors.cpp: In member function 'void RobotControl::analogWrite(uint8_t, uint8_t)':
/home/linwop/Arduino/libraries/Robot_Control/src/Sensors.cpp:65:11: error: 'TKD4' was not declared in this scope
  if(port==TKD4)
           ^
/home/linwop/Arduino/libraries/Robot_Control/src/Sensors.cpp: In member function 'uint8_t RobotControl::_getTypeCode(uint8_t)':
/home/linwop/Arduino/libraries/Robot_Control/src/Sensors.cpp:82:8: error: 'TKD0' was not declared in this scope
   case TKD0:
        ^
/home/linwop/Arduino/libraries/Robot_Control/src/Sensors.cpp:83:8: error: 'TKD1' was not declared in this scope
   case TKD1:
        ^
/home/linwop/Arduino/libraries/Robot_Control/src/Sensors.cpp:84:8: error: 'TKD2' was not declared in this scope
   case TKD2:
        ^
/home/linwop/Arduino/libraries/Robot_Control/src/Sensors.cpp:85:8: error: 'TKD3' was not declared in this scope
   case TKD3:
        ^
/home/linwop/Arduino/libraries/Robot_Control/src/Sensors.cpp:86:8: error: 'TKD4' was not declared in this scope
   case TKD4:
        ^
/home/linwop/Arduino/libraries/Robot_Control/src/Sensors.cpp:87:8: error: 'TKD5' was not declared in this scope
   case TKD5:
        ^
/home/linwop/Arduino/libraries/Robot_Control/src/Sensors.cpp: In member function 'uint8_t RobotControl::_topDPortToAPort(uint8_t)':
/home/linwop/Arduino/libraries/Robot_Control/src/Sensors.cpp:122:8: error: 'TKD0' was not declared in this scope
   case TKD0:
        ^
/home/linwop/Arduino/libraries/Robot_Control/src/Sensors.cpp:124:8: error: 'TKD1' was not declared in this scope
   case TKD1:
        ^
/home/linwop/Arduino/libraries/Robot_Control/src/Sensors.cpp:126:8: error: 'TKD2' was not declared in this scope
   case TKD2:
        ^
/home/linwop/Arduino/libraries/Robot_Control/src/Sensors.cpp:128:8: error: 'TKD3' was not declared in this scope
   case TKD3:
        ^
/home/linwop/Arduino/libraries/Robot_Control/src/Sensors.cpp:130:8: error: 'TKD4' was not declared in this scope
   case TKD4:
        ^
/home/linwop/Arduino/libraries/Robot_Control/src/Sensors.cpp:132:8: error: 'TKD5' was not declared in this scope
   case TKD5:
        ^
/home/linwop/Arduino/libraries/Robot_Control/src/Sensors.cpp:133:12: error: 'A11' was not declared in this scope
     return A11;
            ^
/home/linwop/Arduino/libraries/Robot_Control/src/Sensors.cpp: In member function 'int RobotControl::knobRead()':
/home/linwop/Arduino/libraries/Robot_Control/src/Sensors.cpp:254:22: error: 'POT' was not declared in this scope
  return ::analogRead(POT);
                      ^
exit status 1
/home/linwop/Arduino/libraries/Robot_Control/src/keyboard.cpp: In member function 'int8_t RobotControl::keyboardRead()':
/home/linwop/Arduino/libraries/Robot_Control/src/keyboard.cpp:49:42: error: 'KEY' was not declared in this scope
   lectura_pul = this->averageAnalogInput(KEY);
                                          ^
Error compiling for board Arduino Pro or Pro Mini.

This report would have more information with
"Show verbose output during compilation"
option enabled in File -> Preferences.
`

linwp, 2019-09-25:
It compiled on my work computer. I probably put the files at the wrong place.

Closed 2019-09-25.

Thread 36 (2020-01-10):

Which case are you using in your tutorial?

lshachar, 2020-01-10:
Hi @prunkdump !
Just starting to make another gnuVario, this time I'd like to follow your hardware tutorial and build a complete one (my current does not have a battery or a screen)

I'm wondering what case are you using, do you have a part number, or maybe a 3d model that I could print out?

thank you!  :)

P/S, I'm currently hunting down for the exact components that you're using on your PCB, for obvious reasons - I want everything to work out with the same PCB. It would be great if you could mention the module references in your tutorial.,
I,e, if it helps someone, [micro sd module](https://www.aliexpress.com/item/32867572635.html?spm=a2g0o.cart.0.0.55903c00iYpLCK&mp=1)
Arduino pro mini 3.3V
[micro usb lithium battery charger module 03962A](https://www.aliexpress.com/item/32986135934.html?spm=a2g0o.cart.0.0.55903c00iYpLCK&mp=1)
[spdt switch + 90 deg angle](https://www.aliexpress.com/item/32864652652.html?spm=a2g0o.cart.0.0.55903c00iYpLCK&mp=1)
[MPU9250/MS5611 CJMCU-117](https://www.aliexpress.com/item/32846185344.html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,searchweb201602_1,searchweb201603_53)

prunkdump, 2020-01-13:
Hi Ishachar.

I can't put commercial informations here.

Please contact me with the email address given in my profile. I will sent to you back a complete BOM with all the components needed and where to find them.

Regards,

Baptiste.

lshachar, 2020-02-08:
Hi, I did! (14th January)
Just sent it again.
Thanks for your help :)

Closed 2020-04-07.

Thread 40 (2020-08-14):

wrong accel readings with cheap GY-91

vinmicgra, 2020-08-14:
Im trying to use the cheap GY-91 module which should include bmp-280 and mpu-9250.

BMP-280 works fine but the mpu-9250 is acting strange. When I use "accel-calibration.ino" to check accel data the accelerometer shows working values for all 3 axis but those are way too high.

I think the values are exactly 8192 times too high (2^13). Is there any way to divide all accel readings by (2^13)?

`Ready to make measure.
Don't move the accelerometer and wait...
Starting measure...
accel=(45.55667, 283.25000, 8223.03027)
Standard deviation = 186.76228
-------------------------
Ready to make measure.
`

Thread 41 (2020-10-12):

user manual

alkovar, 2020-10-12:
Hi,
a friend of mine brought to my attention this awesome project and I just completed my first vario yesterday. It does work! But I struggle to find any relevant information about bluetooth pairing, meanings of the symbols on the screen etc. Is there a quick start/user manual, which would explain how to use the vario once it is put together? The VarioSettings.h has some comments but they don't explain everything...

lshachar, 2021-08-21:
Can't help you much, but for what it's worth, it took me over two years with this vario to figure out that a quick tap on it gets it to go into mute mode, and another tap gets it back to normal beeping mode. My first prunkdump vario was headless (without a screen) and there was really no way, no documentation, to read that this was a feature. I thought my arduino board was buggy. On my second vario I have a screen, and it still took me such a long time to finally figure out that it's the tapping (or sometimes, can be triggered by a very strong sink/thermal) that caused the mute mode to trigger.

Hasi123, 2021-08-22:
There is no manual besides https://prunkdump.github.io/GNUVario/
@lshachar I disabled the mute on tap feature as soon as I started to use it, because it quite often triggered itself.

lshachar, 2021-08-22:
@Hasi123 If only I figured by time that it was indeed a feature, and not a bug!
I think this feature should be noted / configured in the varioSettings.h file.
(Or it might have already been, since I'm running an old version of the code)
If you care to write how you disabled it, might help someone else in the future.

Hasi123, 2021-08-22:
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

Here is the commit on my GitHub: https://github.com/Hasi123/HaskoVario/commit/66532e42839baea272d0faa46b3a1db0d5d9cde7

Thread 43 (2022-02-14):

VarioSetting.h and Tutorial

thomaslc66, 2022-02-14:
Hello,

First of all, thank you for your work and what you've done so far.

I've some questions and things I've not fully understood.

In your tutorial (Configuration) you said:

```
So in VarioSettings.h set your Pilot name and Glider name.

Open the SetVarioParameters sketch. Compile and upload it inside your variometer.
```

So I've made some changes in VarioSettings.h and then I'm wondering which files do I need to put in my vario, the hex one? should I rename them? Should they replace the FIRM.hex?

So I've added all 3 of them, even the .ino that seemed a bit not necessary, then started the vario face down heard 3 beeps but the changes were not applied.

Could you please go back to your tutorial and edit a little bit? I've also seen that there is nowhere where do you tell that flashing the card must be done first, so if you start by assembling your vario then you're screwed.

Also in the Hardware when you plug the screen we don't see very well the orientation of the screen and also which wire is not connected. Hopefully, everything is in the schematics but if you are not used to schematics it could be a bit hard to understand.

Thank you for your answer and hope my feedback will help to improve this awesome toll.

Cheers

Thomas
