prunkdump/arduino-variometer/schematic.pdf

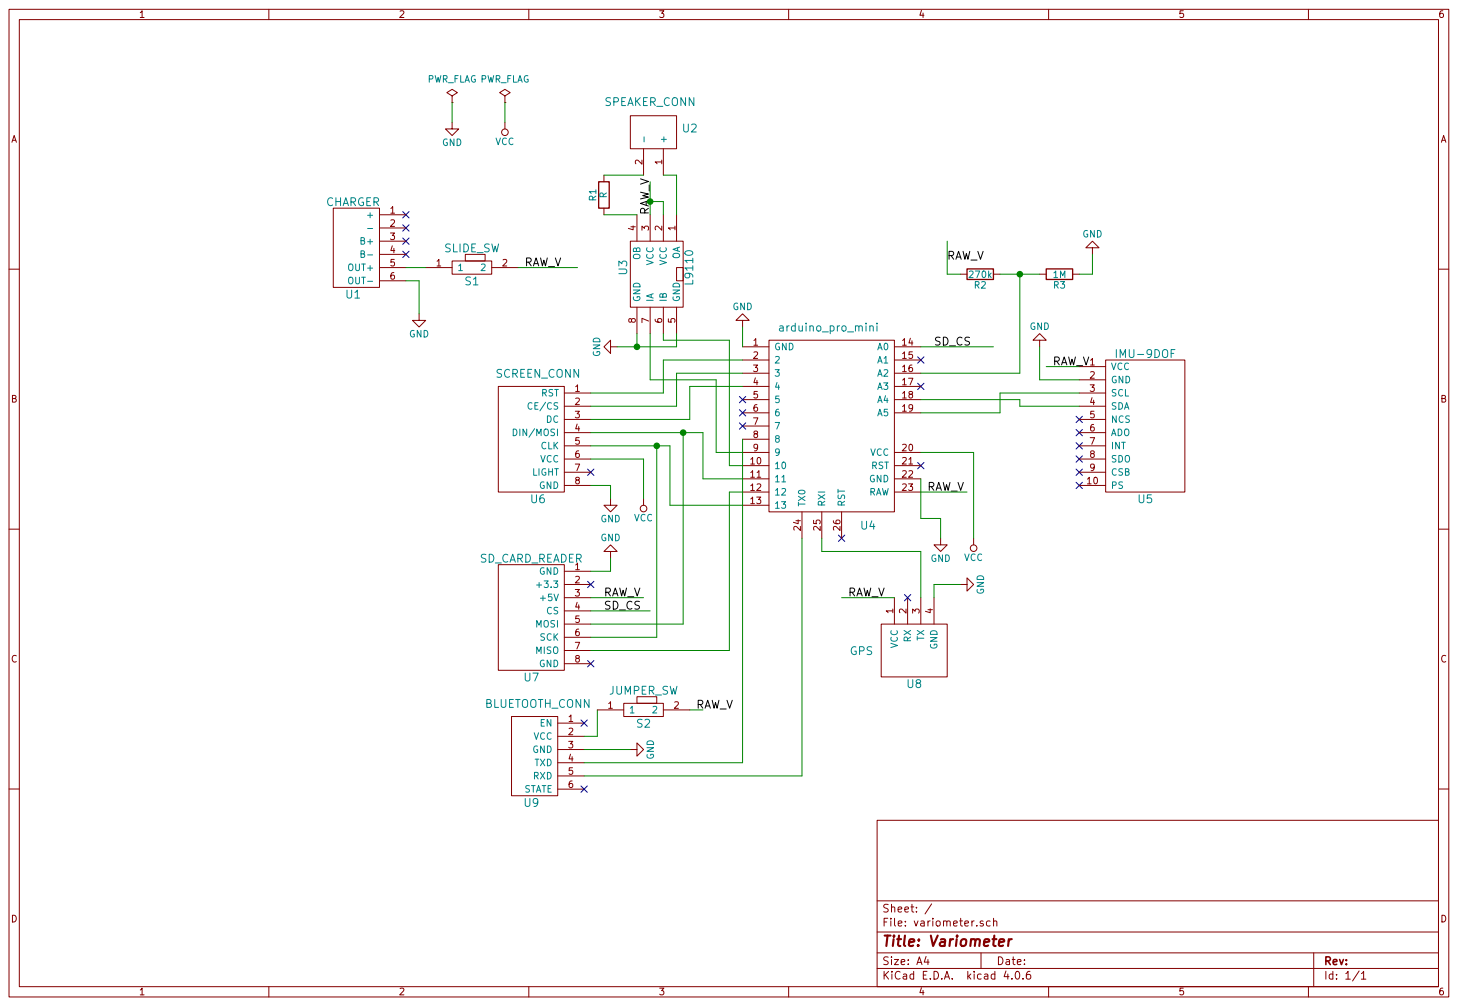
[picture p5: page 1]

Id: 1/1 Title: Variometer File: variometer.sch Sheet: / R1R
