prunkdump/arduino-variometer/(list of files, drawings)

Other design files:
variometer v2.fzz
