prunkdump/arduino-variometer/variometer/variometer.ino

/* variometer -- The GNUVario embedded code
 *
 * Copyright 2016-2019 Baptiste PELLEGRIN
 * Update    2018-2019 Jean-Philippe GOI
 * 
 * This file is part of GNUVario.
 *
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
 * You should have received a copy of the GNU General Public License
 * along with this program.  If not, see <https://www.gnu.org/licenses/>.
 */
 
#include <Arduino.h>
#include <SPI.h>

#include <DebugConfig.h>
#include <HardwareConfig.h>
#include <VarioSettings.h>

#include <IntTW.h>
#include <ms5611.h>
#include <vertaccel.h>

#include <EEPROM.h>
#include <LightInvensense.h>
#include <TwoWireScheduler.h>
#include <kalmanvert.h>

#include <avr/pgmspace.h>
#include <varioscreen.h>
#include <digit.h>
#include <LightSdCard.h>
#include <LightFat16.h>
#include <SerialNmea.h>
#include <NmeaParser.h>
#include <LxnavSentence.h>
#include <LK8Sentence.h>
#include <IGCSentence.h>
#include <FirmwareUpdaterTWS.h>
#include <variostat.h>
#include <FlightHistory.h>

#include <toneHAL.h>
#include <beeper.h>

/*!!!!!!!!!!!!!!!!!!!!!!!!!!!!!!!!!!!!!!!!!!!!!!*/
/*!!            !!! WARNING  !!!              !!*/
/*!! Before building check :                  !!*/
/*!! libraries/VarioSettings/VarioSettings.h  !!*/
/*!!!!!!!!!!!!!!!!!!!!!!!!!!!!!!!!!!!!!!!!!!!!!!*/

/*******************/
/* Version         */
/*******************/

#define VERSION 63
#define SUB_VERSION 97

/*******************/
/*    Historique   */
/*******************/
/* v 63.0     ajout numero de version
 *            ajout mono écran alternatif
 *            lissage de la mesure de la batterie
 *            
 * v 63.1     Ajout tendance vario sur 6sec
 *            Amélioration son vario 
 *            
 * v 63.2     Amélioration du BT            
 * 
 * v 63.3     Version hardware 3
 *            correction BT
 *
 * v 63.4     Ajout mode 3 niveaux dans ToneAC
 *            Modification de la gestion SPI  
 *
 * v 63.5     Optimisation librairie accélerometre - LightInvensense
 *            Ajout Mute sound 
 *            Correction problème de carte SD
 *            ajout HAVE_MUTE pour activer ou non l'option mute
 *            limitation de l'affichage de la vitesse a 99
 *
 * v 63.5.1   ajout du support Neo-8m
 *
 * v 63.6     changement librairie MPU - Accélérometre et Magnetometre
 *            Modification fichier VarioSettings.h pour le Kit V3
 *            
 *            Difference avec la version Prunkdump
 *            
 *            Indicateur de fix Gps (triangle)
 *            Indicateur d'enregistrement (carre)
 *            Indicateur de tendance sur 10sec (fleche)
 *            Alarme sonore de non presence de la carte SD
 *            Bip de fix gps
 *            bip de debut d'enregistrement 
 *    
 *  v 63.6.1  Ajout de l'ecran de stat du dernier vol
 *  
 *  v 63.7.0  01/10/2018
 *            Ajout affichage tendance moyenne sur 5 sec 
 *            en double affichage avec l'indicateur de finesse
 *            Ajout possibilité d'avoir le vario intégré sur N seconde sur 
 *            l'affichage principal
 *            
 *  v 63.7.1  02/11/2018
 *            Ajout du son des dégueulantes variable          
 * 
 *  v 63.8    31/01/2019
 *            Ajout bibliothèque ToneHAL
 *            
 *  v 63.8.1  12/03/2019
 *            Maj ToneHAL
 *            Correction RATIO_CLIMB_RATE
 *            
 *  v 63.9    13/03/2019
 *            Added : New interrupt driven Two Wires library
 *            InvenSenseMotionDriver : switched to IntTW
 *            TwoWireScheduler : added raw mag access
 *            Ms5611 : switched to IntTW library and added static vars optimization
 *            
 * v 63.9.1   23/03/2019            
 *            Maj ToneHAL
 *            
 * v 63.9.2   25/03/2019
 *            IntTW bug : temporarily fallback to wire
 *            ntTW : corrected bug, TWCR must be written at end           
 *            
 * v 63.9.3   fixes the problem of update by retrouncement impossible with certain card SD
 * 
 * v 63.9.4   Corrected bug : FirmwareUpdaterTWS can't compile without accelerometer 
 * 
 * v 63.9.5   14/04/2019
 *            Debbugger SDCARD - ligthFat16
 *
 * v 63.9.6   21/04/2019
 *            Maj SDCARD
 *            Corrected #9 : added option to set the MPU address
 *            TwoWireScheduleur : added error handling
 *            added BMP280 barameter support           
 * v 63.9.7   14/07/2019
 *            add Nmea parameter
 * 
 *******************
 * Compilation :
 * 
 *            Arduino Pro or Pro Mini
 *            ATemega328P (3.3V, 8Mhz)
 *            
 *******************/
 

 
/*******************/
/* General objects */
/*******************/
#define VARIOMETER_STATE_INITIAL 0
#define VARIOMETER_STATE_DATE_RECORDED 1
#define VARIOMETER_STATE_CALIBRATED 2
#define VARIOMETER_STATE_FLIGHT_STARTED 3

#ifdef HAVE_GPS
uint8_t variometerState = VARIOMETER_STATE_INITIAL;
#else
uint8_t variometerState = VARIOMETER_STATE_CALIBRATED;
#endif //HAVE_GPS

/***************/
/* IMU objects */
/***************/
#ifdef HAVE_BMP280
Bmp280 TWScheduler::bmp280;
#else
Ms5611 TWScheduler::ms5611;
#endif

#ifdef HAVE_ACCELEROMETER
Vertaccel TWScheduler::vertaccel;
#endif //HAVE_ACCELEROMETER

/*****************/
/* screen objets */
/*****************/
#ifdef HAVE_SCREEN

unsigned long lastLowFreqUpdate = 0;

#ifdef HAVE_GPS 
#ifdef HAVE_SCREEN_JPG63
#define VARIOSCREEN_ALTI_ANCHOR_X 50
#define VARIOSCREEN_ALTI_ANCHOR_Y 0
#define VARIOSCREEN_VARIO_ANCHOR_X 40
#define VARIOSCREEN_VARIO_ANCHOR_Y 2
#define VARIOSCREEN_TIME_ANCHOR_X 38
#define VARIOSCREEN_TIME_ANCHOR_Y 4
#define VARIOSCREEN_ELAPSED_TIME_ANCHOR_X 38
#define VARIOSCREEN_ELAPSED_TIME_ANCHOR_Y 4
#define VARIOSCREEN_SPEED_ANCHOR_X 22
#define VARIOSCREEN_SPEED_ANCHOR_Y 4
#define VARIOSCREEN_GR_ANCHOR_X 84
#define VARIOSCREEN_GR_ANCHOR_Y 2
#define VARIOSCREEN_TREND_ANCHOR_X 48
#define VARIOSCREEN_TREND_ANCHOR_Y 2
#else
#define VARIOSCREEN_ALTI_ANCHOR_X 52
#define VARIOSCREEN_ALTI_ANCHOR_Y 0
#define VARIOSCREEN_VARIO_ANCHOR_X 52
#define VARIOSCREEN_VARIO_ANCHOR_Y 2
#define VARIOSCREEN_TIME_ANCHOR_X 5
#define VARIOSCREEN_TIME_ANCHOR_Y 0
#define VARIOSCREEN_ELAPSED_TIME_ANCHOR_X 5
#define VARIOSCREEN_ELAPSED_TIME_ANCHOR_Y 3
#define VARIOSCREEN_SPEED_ANCHOR_X 22
#define VARIOSCREEN_SPEED_ANCHOR_Y 4
#define VARIOSCREEN_GR_ANCHOR_X 72
#define VARIOSCREEN_GR_ANCHOR_Y 4
#define VARIOSCREEN_TREND_ANCHOR_X 60
#define VARIOSCREEN_TREND_ANCHOR_Y 2
#endif //HAVE_SCREEN_JPG63
#define RATIO_MAX_VALUE 30.0
#define RATIO_MIN_SPEED 10.0
#else
#define VARIOSCREEN_ALTI_ANCHOR_X 52
#define VARIOSCREEN_ALTI_ANCHOR_Y 1
#define VARIOSCREEN_VARIO_ANCHOR_X 52
#define VARIOSCREEN_VARIO_ANCHOR_Y 3
#endif //HAVE_GPS

#define VARIOSCREEN_BAT_ANCHOR_X 68
#define VARIOSCREEN_BAT_ANCHOR_Y 1
#define VARIOSCREEN_SAT_ANCHOR_X 68
#define VARIOSCREEN_SAT_ANCHOR_Y 0

#define VARIOSCREEN_RECORD_ANCHOR_X 2
#define VARIOSCREEN_RECORD_ANCHOR_Y 0

#define VARIOSCREEN_MUTE_ANCHOR_X 0
#define VARIOSCREEN_MUTE_ANCHOR_Y 1

VarioScreen screen(VARIOSCREEN_DC_PIN,VARIOSCREEN_CS_PIN,VARIOSCREEN_RST_PIN);
MSUnit msunit(screen, VARIOSCREEN_VARIO_ANCHOR_X, VARIOSCREEN_VARIO_ANCHOR_Y);
MUnit munit(screen, VARIOSCREEN_ALTI_ANCHOR_X, VARIOSCREEN_ALTI_ANCHOR_Y);
ScreenDigit altiDigit(screen, VARIOSCREEN_ALTI_ANCHOR_X, VARIOSCREEN_ALTI_ANCHOR_Y, 0, false);
ScreenDigit varioDigit(screen, VARIOSCREEN_VARIO_ANCHOR_X, VARIOSCREEN_VARIO_ANCHOR_Y, 1, true);
#ifdef HAVE_GPS
ScreenDigit speedDigit(screen, VARIOSCREEN_SPEED_ANCHOR_X, VARIOSCREEN_SPEED_ANCHOR_Y, 0, false);
#ifdef HAVE_SCREEN_JPG63
ScreenDigit ratioDigit(screen, VARIOSCREEN_GR_ANCHOR_X, VARIOSCREEN_GR_ANCHOR_Y, 0, false);
ScreenDigit trendDigit(screen, VARIOSCREEN_GR_ANCHOR_X, VARIOSCREEN_GR_ANCHOR_Y, 1, false);
#else
ScreenDigit ratioDigit(screen, VARIOSCREEN_GR_ANCHOR_X, VARIOSCREEN_GR_ANCHOR_Y, 1, false);
#endif //HAVE_SCREEN_JPG63
KMHUnit kmhunit(screen, VARIOSCREEN_SPEED_ANCHOR_X, VARIOSCREEN_SPEED_ANCHOR_Y);
#ifndef HAVE_SCREEN_JPG63 
GRUnit grunit(screen, VARIOSCREEN_GR_ANCHOR_X, VARIOSCREEN_GR_ANCHOR_Y);
#endif //HAVE_SCREEN_JPG63
SATLevel satLevel(screen, VARIOSCREEN_SAT_ANCHOR_X, VARIOSCREEN_SAT_ANCHOR_Y);
RECORDIndicator recordIndicator(screen, VARIOSCREEN_RECORD_ANCHOR_X, VARIOSCREEN_RECORD_ANCHOR_Y);
TRENDLevel trendLevel(screen, VARIOSCREEN_TREND_ANCHOR_X, VARIOSCREEN_TREND_ANCHOR_Y);

ScreenTime screenTime(screen, VARIOSCREEN_TIME_ANCHOR_X, VARIOSCREEN_TIME_ANCHOR_Y);
ScreenElapsedTime screenElapsedTime(screen, VARIOSCREEN_ELAPSED_TIME_ANCHOR_X, VARIOSCREEN_ELAPSED_TIME_ANCHOR_Y);
#endif //HAVE_GPS
#ifdef HAVE_ACCELEROMETER
ScreenMuteIndicator muteIndicator(screen, VARIOSCREEN_MUTE_ANCHOR_X, VARIOSCREEN_MUTE_ANCHOR_Y);
#endif //HAVE_ACCELEROMETER
#ifdef HAVE_VOLTAGE_DIVISOR
BATLevel batLevel(screen, VARIOSCREEN_BAT_ANCHOR_X, VARIOSCREEN_BAT_ANCHOR_Y, VOLTAGE_DIVISOR_VALUE, VOLTAGE_DIVISOR_REF_VOLTAGE);
int maxVoltage = 0;
#endif //HAVE_VOLTAGE_DIVISOR


ScreenSchedulerObject displayList[] = { {&msunit, 0}, {&munit, 0}, {&altiDigit, 0}, {&varioDigit, 0}
#ifdef HAVE_GPS
#ifdef HAVE_SCREEN_JPG63
  									   ,{&kmhunit, 0}, {&speedDigit, 0}, {&trendDigit, 1}, {&ratioDigit, 0}, {&satLevel, 0}, {&screenTime, 1}, {&screenElapsedTime, 0}, {&recordIndicator, 0} , {&trendLevel, 0}
#else
                                       ,{&kmhunit, 0}, {&grunit, 0}, {&speedDigit, 0}, {&ratioDigit, 0}, {&satLevel, 0}, {&screenTime, 1}, {&screenElapsedTime, 1}, {&recordIndicator, 0} , {&trendLevel, 0}
#endif //HAVE_SCREEN_JPG63  
#endif //HAVE_GPS
#ifdef HAVE_ACCELEROMETER
                                       ,{&muteIndicator, 0}
#endif //HAVE_ACCELEROMETER
#ifdef HAVE_VOLTAGE_DIVISOR
                                       , {&batLevel, 0}
#endif //HAVE_VOLTAGE_DIVISOR
};

#ifdef HAVE_GPS
#ifdef HAVE_SCREEN_JPG63
ScreenScheduler varioScreen(screen, displayList, sizeof(displayList)/sizeof(ScreenSchedulerObject), 0, 0);
bool DisplayDuration;
#else
ScreenScheduler varioScreen(screen, displayList, sizeof(displayList)/sizeof(ScreenSchedulerObject), 0, 1);
#endif //HAVE_SCREEN_JPG63  
#else
ScreenScheduler varioScreen(screen, displayList, sizeof(displayList)/sizeof(ScreenSchedulerObject), 0, 0);
#endif //HAVE_GPS

#endif //HAVE_SCREEN

/**********************/
/* alti/vario objects */
/**********************/
#define POSITION_MEASURE_STANDARD_DEVIATION 0.1
#ifdef HAVE_ACCELEROMETER 
#define ACCELERATION_MEASURE_STANDARD_DEVIATION 0.3
#else
#define ACCELERATION_MEASURE_STANDARD_DEVIATION 0.6
#endif //HAVE_ACCELEROMETER 

kalmanvert kalmanvert;

#ifdef HAVE_SPEAKER
ToneHAL toneHAL;
beeper beeper(VARIOMETER_SINKING_THRESHOLD, VARIOMETER_CLIMBING_THRESHOLD, VARIOMETER_NEAR_CLIMBING_SENSITIVITY, VARIOMETER_BEEP_VOLUME);
#define BEEP_FREQ 800
#endif

/************************************/
/* glide ratio / average climb rate */
/************************************/
#if defined(HAVE_GPS) || defined(VARIOMETER_DISPLAY_INTEGRATED_CLIMB_RATE) || (RATIO_CLIMB_RATE > 1)

/* determine history params */
#ifdef HAVE_GPS
#if defined(VARIOMETER_DISPLAY_INTEGRATED_CLIMB_RATE) || (RATIO_CLIMB_RATE > 1)
/* unsure period divide GPS_PERIOD */
constexpr double historyGPSPeriodCountF = (double)(VARIOMETER_INTEGRATED_CLIMB_RATE_DISPLAY_FREQ)*(double)(GPS_PERIOD)/(1000.0);
constexpr int8_t historyGPSPeriodCount = (int8_t)(0.5 + historyGPSPeriodCountF);

constexpr double historyPeriodF = (double)(GPS_PERIOD)/(double)(historyGPSPeriodCount);
constexpr unsigned historyPeriod = (unsigned)(0.5 + historyPeriodF);
#else
/* GPS give the period */
constexpr int8_t historyGPSPeriodCount = 1;
constexpr unsigned historyPeriod = GPS_PERIOD;
#endif //VARIOMETER_DISPLAY_INTEGRATED_CLIMB_RATE || (RATIO_CLIMB_RATE > 1)

constexpr double historyCountF = (double)(VARIOMETER_GLIDE_RATIO_INTEGRATION_TIME)/(double)historyPeriod;
constexpr int8_t historyCount = (int8_t)(0.5 + historyCountF);
#else //!HAVE_GPS
constexpr double historyCountF = (double)(VARIOMETER_INTEGRATED_CLIMB_RATE_DISPLAY_FREQ)*(double)(VARIOMETER_CLIMB_RATE_INTEGRATION_TIME)/(1000.0);
constexpr int8_t historyCount = (int8_t)(0.5 + historyCountF);

constexpr double historyPeriodF = (double)(VARIOMETER_CLIMB_RATE_INTEGRATION_TIME)/(double)historyCount;
constexpr unsigned historyPeriod = (unsigned)(0.5 + historyPeriodF);
#endif //HAVE_GPS

/* create history */
#ifdef HAVE_GPS
SpeedFlightHistory<historyPeriod, historyCount, historyGPSPeriodCount> history;
#else
#ifdef VARIOMETER_DISPLAY_INTEGRATED_CLIMB_RATE
FlightHistory<historyPeriod, historyCount> history;
#endif //VARIOMETER_DISPLAY_INTEGRATED_CLIMB_RATE
#endif //HAVE_GPS

/* compute climb rate period count when differ from glide ratio period count */
#if defined(HAVE_GPS) && defined(VARIOMETER_DISPLAY_INTEGRATED_CLIMB_RATE)
#if VARIOMETER_CLIMB_RATE_INTEGRATION_TIME > VARIOMETER_GLIDE_RATIO_INTEGRATION_TIME
#error VARIOMETER_CLIMB_RATE_INTEGRATION_TIME must be less or equal than VARIOMETER_GLIDE_RATIO_INTEGRATION_TIME
#endif
constexpr double historyClimbRatePeriodCountF = (double)(VARIOMETER_CLIMB_RATE_INTEGRATION_TIME)/(double)historyPeriod;
constexpr int8_t historyClimbRatePeriodCount = (int8_t)historyClimbRatePeriodCountF;
#endif

#endif //defined(HAVE_GPS) || defined(VARIOMETER_DISPLAY_INTEGRATED_CLIMB_RATE) || (RATIO_CLIMB_RATE > 1)

/***************/
/* gps objects */
/***************/
#ifdef HAVE_GPS

NmeaParser nmeaParser;

#ifdef HAVE_BLUETOOTH
boolean lastSentence = false;
#endif //HAVE_BLUETOOTH

#ifdef HAVE_SDCARD
lightfat16 file;
IGCHeader header;
IGCSentence igc;

#define SDCARD_STATE_INITIAL 0
#define SDCARD_STATE_INITIALIZED 1
#define SDCARD_STATE_READY 2
#define SDCARD_STATE_ERROR -1
int8_t sdcardState = SDCARD_STATE_INITIAL;

#endif //HAVE_SDCARD

#endif //HAVE_GPS

/*********************/
/* bluetooth objects */
/*********************/
#ifdef HAVE_BLUETOOTH
#if defined(VARIOMETER_SENT_LXNAV_SENTENCE)
LxnavSentence bluetoothNMEA;
#elif defined(VARIOMETER_SENT_LK8000_SENTENCE)
LK8Sentence bluetoothNMEA;
#else
#error No bluetooth sentence type specified !
#endif

#ifndef HAVE_GPS
unsigned long lastVarioSentenceTimestamp = 0;
#endif // !HAVE_GPS
#endif //HAVE_BLUETOOTH

#if defined(HAVE_ACCELEROMETER) && defined(HAVE_SPEAKER) 
/* tap callback : mute/unmute beeper */
void beeperTapCallback(unsigned char direction, unsigned char count) { 

  static bool muted = false;
  muted = !muted;
  toneHAL.mute(muted);
#ifdef HAVE_SCREEN
  muteIndicator.setMuteState(muted);
#endif //HAVE_SCREEN
}
#endif //defined(HAVE_ACCELEROMETER) && defined(HAVE_SPEAKER) 

#ifdef HAVE_SCREEN_JPG63
VarioStat flystat;
//VarioTrend CalculTrend;
#endif //HAVE_SCREEN_JPG63

/*-----------------*/
/*      SETUP      */
/*-----------------*/
void setup() {

  /*****************************/
  /* wait for devices power on */
  /*****************************/
  delay(VARIOMETER_POWER_ON_DELAY);

  /******************/
  /* Init Speaker   */
  /******************/
  
#if defined( HAVE_SPEAKER)
  toneHAL.init();
#endif

  /************/
  /* init SPI */
  /************/
  
  /* set all SPI CS lines before talking to devices */
#if defined(HAVE_SDCARD) && defined(HAVE_GPS)
  file.enableSPI();
#endif //defined(HAVE_SDCARD) && defined(HAVE_GPS)

  /**********************/
  /* init Two Wires devices */
  /**********************/
  intTW.begin();
  twScheduler.init();
#ifdef HAVE_ACCELEROMETER
  if( firmwareUpdateCondTWS() ) {
   firmwareUpdate();
  }
#ifdef HAVE_MUTE  
  fastMPUSetTapCallback(beeperTapCallback);
#endif //HAVE_MUTE
#endif //HAVE_ACCELEROMETER

  /****************/
  /* init SD Card */
  /****************/

#if defined(HAVE_SDCARD) && defined(HAVE_GPS)
  if( file.init() >= 0 ) {
    sdcardState = SDCARD_STATE_INITIALIZED;  //useless to set error
  }
#endif //defined(HAVE_SDCARD) && defined(HAVE_GPS)

  /*******************/
  /* init SPI SCREEN */
  /*******************/

#ifdef HAVE_SCREEN
  screen.enableSPI();
#endif //HAVE_SCREEN

  /****************/
  /* Alarm SD Card */
  /****************/

  if (sdcardState == VARIOMETER_STATE_INITIAL) {
#if defined( HAVE_SPEAKER) && defined (ALARM_SDCARD)
   for( int i = 0; i<4; i++) {
       toneHAL.tone(900);
       delay(1000);
       toneHAL.tone(0);
    }       
#endif //HAVE_SPEAKER && ALARM_SDCARD
  }  

#ifdef HAVE_SCREEN_JPG63
  flystat.Display();
#endif //HAVE_SCREEN_JPG63
   
  /***************/
  /* init screen */
  /***************/
#ifdef HAVE_SCREEN
  screen.begin(VARIOSCREEN_CONTRAST);
 
 #ifdef HAVE_SCREEN_JPG63
  unsigned long timer = millis();
  int8_t tmptime[] = {0,SUB_VERSION,VERSION};
  screenTime.setTime(tmptime);
 
  varioScreen.setPage(1);
  DisplayDuration = true;
  screenTime.update();
  screenTime.display();

#ifdef HAVE_VOLTAGE_DIVISOR
      /* update battery level */
      batLevel.setVoltage( analogRead(VOLTAGE_DIVISOR_PIN) );
      batLevel.update();
      batLevel.display();
#endif //HAVE_VOLTAGE_DIVISOR

  altiDigit.setValue(flystat.GetAlti());
  altiDigit.update();
  altiDigit.display();
  varioDigit.setValue(flystat.GetVarioMin());
  varioDigit.update();
  varioDigit.display();
  double tmpspeed = flystat.GetSpeed();
  if (tmpspeed > 99) tmpspeed = 99;
  speedDigit.setValue(tmpspeed);
  speedDigit.update();
  speedDigit.display();
  kmhunit.update();
  kmhunit.display();
  msunit.update();
  msunit.display();
  munit.update();  
  munit.display();

  varioScreen.displayStep();
 #endif HAVE_SCREEN_JPG63
 #endif //HAVE_SCREEN
    
  /**************************/
  /* init gps and bluetooth */
  /**************************/
#if defined(HAVE_BLUETOOTH) || defined(HAVE_GPS)
#ifdef HAVE_GPS
  serialNmea.begin(GPS_BLUETOOTH_BAUDS, true);
#else
  serialNmea.begin(GPS_BLUETOOTH_BAUDS, false);
#endif //HAVE_GPS
#endif //defined(HAVE_BLUETOOTH) || defined(HAVE_GPS)
  
  /******************/
  /* get first data */
  /******************/
  
  /* wait for first alti and acceleration */
  while( ! twScheduler.havePressure() ) { }

  /* init kalman filter with 0.0 accel*/
  double firstAlti = twScheduler.getAlti();
  kalmanvert.init(firstAlti,
                  0.0,
                  POSITION_MEASURE_STANDARD_DEVIATION,
                  ACCELERATION_MEASURE_STANDARD_DEVIATION,
                  millis());

  /* init history */
#if defined(HAVE_GPS) || defined(VARIOMETER_DISPLAY_INTEGRATED_CLIMB_RATE) || (RATIO_CLIMB_RATE > 1)
  history.init(firstAlti, millis());
#endif //defined(HAVE_GPS) || defined(VARIOMETER_DISPLAY_INTEGRATED_CLIMB_RATE) || (RATIO_CLIMB_RATE > 1)

 #ifdef HAVE_SCREEN_JPG63
  while ((millis() - timer) < 3000) {   
  }

  screenTime.setTime(flystat.GetDuration());
  screenTime.update();
  screenTime.display();
  varioDigit.setValue(flystat.GetVarioMax());
  varioDigit.update();
  varioDigit.display();

  DisplayDuration = true;
  varioScreen.setPage(1);
  delay(3000); 
  speedDigit.setValue(0);

  if (RATIO_CLIMB_RATE == 1) {  
    displayList[6].page  = 1;
    displayList[7].page  = 0;
  }
  else if (RATIO_CLIMB_RATE == 2) {
    displayList[6].page  = 0;
    displayList[7].page  = 1;
  }

//  CalculTrend.Init();  
}
#endif //HAVE_SCREEN_JPG63

#if defined(HAVE_SDCARD) && defined(HAVE_GPS)
void createSDCardTrackFile(void);
#endif //defined(HAVE_SDCARD) && defined(HAVE_GPS)
void enableflightStartComponents(void);

/*----------------*/
/*      LOOP      */
/*----------------*/
void loop() {
 
  /*****************************/
  /* compute vertical velocity */
  /*****************************/
#ifdef HAVE_ACCELEROMETER
  if( twScheduler.havePressure() && twScheduler.haveAccel() ) {
    kalmanvert.update( twScheduler.getAlti(),
                       twScheduler.getAccel(NULL),
                       millis() );
#else
  if( twScheduler.havePressure() ) {
    kalmanvert.update( twScheduler.getAlti(),
                       0.0,
                       millis() );
#endif //HAVE_ACCELEROMETER

    /* set beeper */
#ifdef HAVE_SPEAKER
    beeper.setVelocity( kalmanvert.getVelocity() );
#endif //HAVE_SPEAKER

    /* set history */
#if defined(HAVE_GPS) || defined(VARIOMETER_DISPLAY_INTEGRATED_CLIMB_RATE) || (RATIO_CLIMB_RATE > 1)
    history.setAlti(kalmanvert.getCalibratedPosition(), millis());
#endif

double currentalti  = kalmanvert.getCalibratedPosition();
double currentvario = kalmanvert.getVelocity();

    /* set screen */

#ifdef HAVE_SCREEN_JPG63
    flystat.SetAlti(currentalti);
    flystat.SetVario(currentvario);
#endif //HAVE_SCREENçJPG63

#ifdef HAVE_SCREEN
    altiDigit.setValue(currentalti);
#ifdef HAVE_SCREEN_JPG63
#ifdef VARIOMETER_DISPLAY_INTEGRATED_CLIMB_RATE
    if( history.haveNewClimbRate() ) {
      varioDigit.setValue(history.getClimbRate());
    }
#else
    varioDigit.setValue(currentvario);
#endif //VARIOMETER_DISPLAY_INTEGRATED_CLIMB_RATE   

#if (RATIO_CLIMB_RATE > 1) 
    if( history.haveNewClimbRate() ) {
      double TmpTrend;
      TmpTrend = history.getClimbRate();
      if (abs(TmpTrend) < 10) trendDigit.setValue(abs(TmpTrend)); 
      else                    trendDigit.setValue(9.9);
      
      if (TmpTrend == 0)     trendLevel.stateTREND(0);
      else if (TmpTrend > 0) trendLevel.stateTREND(1);
      else                   trendLevel.stateTREND(-1);
    }  
#endif // (RATIO_CLIMB_RATE > 1)
#else
#ifdef VARIOMETER_DISPLAY_INTEGRATED_CLIMB_RATE
    if( history.haveNewClimbRate() ) {
      varioDigit.setValue(history.getClimbRate());
    }
#else
    varioDigit.setValue(currentvario);
#endif //VARIOMETER_DISPLAY_INTEGRATED_CLIMB_RATE
#endif //HAVE_SCREEN_JPG63
#endif //HAVE_SCREEN
     
  }

  /*****************/
  /* update beeper */
  /*****************/
#ifdef HAVE_SPEAKER
  beeper.update();
#endif //HAVE_SPEAKER

  /********************/
  /* update bluetooth */
  /********************/
#ifdef HAVE_BLUETOOTH
#ifdef HAVE_GPS
  /* in priority send vario nmea sentence */
  if( bluetoothNMEA.available() ) {
    while( bluetoothNMEA.available() ) {
       serialNmea.write( bluetoothNMEA.get() );
    }
    serialNmea.release();
  }
#else //!HAVE_GPS
  /* check the last vario nmea sentence */
  if( millis() - lastVarioSentenceTimestamp > VARIOMETER_SENTENCE_DELAY ) {
    lastVarioSentenceTimestamp = millis();
#ifdef VARIOMETER_BLUETOOTH_SEND_CALIBRATED_ALTITUDE
    bluetoothNMEA.begin(kalmanvert.getCalibratedPosition(), kalmanvert.getVelocity());
#else
    bluetoothNMEA.begin(kalmanvert.getPosition(), kalmanvert.getVelocity());
#endif
    while( bluetoothNMEA.available() ) {
       serialNmea.write( bluetoothNMEA.get() );
    }
  }
#endif //!HAVE_GPS
#endif //HAVE_BLUETOOTH


  /**************/
  /* update GPS */
  /**************/
#ifdef HAVE_GPS
#ifdef HAVE_BLUETOOTH
  /* else try to parse GPS nmea */
  else {
#endif //HAVE_BLUETOOTH
    
    /* try to lock sentences */
    if( serialNmea.lockRMC() ) {
      nmeaParser.beginRMC();
    } else if( serialNmea.lockGGA() ) {
      nmeaParser.beginGGA();
#ifdef HAVE_BLUETOOTH
      lastSentence = true;
#endif //HAVE_BLUETOOTH
#ifdef HAVE_SDCARD      

      /* start to write IGC B frames */
      if( sdcardState == SDCARD_STATE_READY ) {
#ifdef VARIOMETER_SDCARD_SEND_CALIBRATED_ALTITUDE
        file.write( igc.begin( kalmanvert.getCalibratedPosition() ) );
#else
        file.write( igc.begin( kalmanvert.getPosition() ) );
#endif
      }
#endif //HAVE_SDCARD
    }
  
    /* parse if needed */
    if( nmeaParser.isParsing() ) {
      while( nmeaParser.isParsing() ) {
        uint8_t c = serialNmea.read();
        
        /* parse sentence */        
        nmeaParser.feed( c );

#ifdef HAVE_SDCARD          
        /* if GGA, convert to IGC and write to sdcard */
        if( sdcardState == SDCARD_STATE_READY && nmeaParser.isParsingGGA() ) {
          igc.feed(c);
          while( igc.available() ) {
            file.write( igc.get() );
          }
        }
#endif //HAVE_SDCARD
      }
      serialNmea.release();
    
#ifdef HAVE_BLUETOOTH   
      /* if this is the last GPS sentence */
      /* we can send our sentences */
      if( lastSentence ) {
          lastSentence = false;
#ifdef VARIOMETER_BLUETOOTH_SEND_CALIBRATED_ALTITUDE
          bluetoothNMEA.begin(kalmanvert.getCalibratedPosition(), kalmanvert.getVelocity());
#else
          bluetoothNMEA.begin(kalmanvert.getPosition(), kalmanvert.getVelocity());
#endif
          serialNmea.lock(); //will be writed at next loop
      }
#endif //HAVE_BLUETOOTH
    }
  
  
    /***************************/
    /* update variometer state */
    /*    (after parsing)      */
    /***************************/
    if( variometerState < VARIOMETER_STATE_FLIGHT_STARTED ) {

      /* if initial state check if date is recorded  */
      if( variometerState == VARIOMETER_STATE_INITIAL ) {
        if( nmeaParser.haveDate() ) {
          variometerState = VARIOMETER_STATE_DATE_RECORDED;
        }
      }
      
      /* check if we need to calibrate the altimeter */
      else if( variometerState == VARIOMETER_STATE_DATE_RECORDED ) {
        
        /* we need a good quality value */
        if( nmeaParser.haveNewAltiValue() && nmeaParser.precision < VARIOMETER_GPS_ALTI_CALIBRATION_PRECISION_THRESHOLD ) {
          
          /* calibrate */
 #if defined(HAVE_SPEAKER) && defined(ALARM_GPSFIX)
          toneHAL.tone(BEEP_FREQ);
          delay(200);
          toneHAL.tone(0);
 #endif //defined(HAVE_SPEAKER) && defined(ALARM_GPSFIX)

#ifdef HAVE_SCREEN
          recordIndicator.setActifGPSFIX();
#endif //HAVE_SCREEN  
                  
          double gpsAlti = nmeaParser.getAlti();
          kalmanvert.calibratePosition(gpsAlti);

#if defined(HAVE_GPS) || defined(VARIOMETER_DISPLAY_INTEGRATED_CLIMB_RATE) || (RATIO_CLIMB_RATE > 1)
          history.init(gpsAlti, millis());
#endif //defined(HAVE_GPS) || defined(VARIOMETER_DISPLAY_INTEGRATED_CLIMB_RATE) || (RATIO_CLIMB_RATE > 1)

          variometerState = VARIOMETER_STATE_CALIBRATED;
#if defined(HAVE_SDCARD) && ! defined(VARIOMETER_RECORD_WHEN_FLIGHT_START)
          createSDCardTrackFile();
#endif //defined(HAVE_SDCARD) && ! defined(VARIOMETER_RECORD_WHEN_FLIGHT_START)
        }
      }
      
      /* else check if the flight have started */
      else {  //variometerState == VARIOMETER_STATE_CALIBRATED
        
        /* check flight start condition */
        if( (millis() > FLIGHT_START_MIN_TIMESTAMP) 
#if defined( VARIOMETER_RECORD_WHEN_FLIGHT_START )       
          && (kalmanvert.getVelocity() < FLIGHT_START_VARIO_LOW_THRESHOLD || kalmanvert.getVelocity() > FLIGHT_START_VARIO_HIGH_THRESHOLD) &&
            (nmeaParser.getSpeed() > FLIGHT_START_MIN_SPEED) 
#endif   //defined(VARIOMETER_RECORD_WHEN_FLIGHT_START)           
          ) {
          variometerState = VARIOMETER_STATE_FLIGHT_STARTED;
          enableflightStartComponents();
        }
      }
    }
#ifdef HAVE_BLUETOOTH
  }
#endif //HAVE_BLUETOOTH
#endif //HAVE_GPS

  /* if no GPS, we can't calibrate, and we have juste to check flight start */
#ifndef HAVE_GPS
  if( variometerState == VARIOMETER_STATE_CALIBRATED ) { //already calibrated at start 
    if( (millis() > FLIGHT_START_MIN_TIMESTAMP) 
#if defined ( VARIOMETER_RECORD_WHEN_FLIGHT_START )      
      && (kalmanvert.getVelocity() < FLIGHT_START_VARIO_LOW_THRESHOLD || kalmanvert.getVelocity() > FLIGHT_START_VARIO_HIGH_THRESHOLD) 
#endif   //defined(VARIOMETER_RECORD_WHEN_FLIGHT_START)           
    ) {
      variometerState = VARIOMETER_STATE_FLIGHT_STARTED;
      enableflightStartComponents();
    }
  }
#endif // !HAVE_GPS

#if defined(HAVE_SCREEN) && defined(HAVE_VOLTAGE_DIVISOR) 
int tmpVoltage = analogRead(VOLTAGE_DIVISOR_PIN);
if (maxVoltage < tmpVoltage) {maxVoltage = tmpVoltage;}
#endif //HAVE_VOLTAGE_DIVISOR


  /**********************************/
  /* update low freq screen objects */
  /**********************************/
#ifdef HAVE_SCREEN
  unsigned long lowFreqDuration = millis() - lastLowFreqUpdate;
#ifdef HAVE_SCREEN_JPG63
  if( DisplayDuration == false ) {
#else    
  if( varioScreen.getPage() == 0 ) {
#endif //HAVE_SCREEN_JPG63
    if( lowFreqDuration > VARIOMETER_BASE_PAGE_DURATION ) {
#ifdef HAVE_GPS //no multipage without GPS

#ifdef HAVE_SCREEN_JPG63   

/*      if (RATIO_CLIMB_RATE == 1) {  
        displayList[6].page  = 1;
        displayList[7].page  = 0;
      }
      else if (RATIO_CLIMB_RATE == 2) {
        displayList[6].page  = 0;
        displayList[7].page  = 1;
      }
      else {
        displayList[6].page  = 1;
        displayList[7].page  = 0;
      }
*/

#if (RATIO_CLIMB_RATE > 2)
        displayList[6].page  = 1;
        displayList[7].page  = 0;
#endif


//      displayList[12].page = 1;

      displayList[9].page = 1;
      displayList[10].page = 0;
             
      DisplayDuration = true;
      varioScreen.setPage(0);
#else      
      varioScreen.nextPage();
#endif //HAVE_SCREEN_JPG63
    }
  } else { //page == 1
    if( lowFreqDuration > VARIOMETER_BASE_PAGE_DURATION + VARIOMETER_ALTERNATE_PAGE_DURATION ) {
#endif //HAVE_GPS multipage support
      lastLowFreqUpdate = millis();

#ifdef HAVE_GPS
      /* set time */
      screenTime.setTime( nmeaParser.time );
      screenTime.correctTimeZone( VARIOMETER_TIME_ZONE );
      screenElapsedTime.setCurrentTime( screenTime.getTime() );

 #ifdef HAVE_SCREEN_JPG63
      flystat.SetDuration(screenElapsedTime.getTime());
 #endif //HAVE_SCREEN_JPG63
 
      /* update satelite count */
      satLevel.setSatelliteCount( nmeaParser.satelliteCount );
#endif //HAVE_GPS  

#ifdef HAVE_VOLTAGE_DIVISOR
      /* update battery level */
//      batLevel.setVoltage( analogRead(VOLTAGE_DIVISOR_PIN) );
      batLevel.setVoltage( maxVoltage );
      maxVoltage = 0;
#endif //HAVE_VOLTAGE_DIVISOR
#ifdef HAVE_SCREEN_JPG63 
     
/*      if (RATIO_CLIMB_RATE == 1) {  
        displayList[6].page = 1;
        displayList[7].page = 0;
      }
      #elseif (RATIO_CLIMB_RATE == 2)
      displayList[6].page = 0;
      displayList[7].page = 1;
#else*/
#if (RATIO_CLIMB_RATE > 2)
      displayList[6].page = 0;
      displayList[7].page = 1;
#endif   

//      displayList[12].page = 0;

      displayList[9].page = 0;
      displayList[10].page = 1;
       
      DisplayDuration = false;
      varioScreen.setPage(0);

#endif //HAVE_SCREEN_JPG63         
#ifdef  HAVE_GPS  //no multipage without GPS
#ifndef HAVE_SCREEN_JPG63
      varioScreen.nextPage();
#endif //HAVE_SCREEN_JPG63      
#endif //HAVE_GPS multipage support      
    }
  }
  
  /*****************/
  /* update screen */
  /*****************/
#ifdef HAVE_GPS
  /* when getting speed from gps, display speed and ratio */
  if ( nmeaParser.haveNewSpeedValue() ) {

    double currentSpeed = nmeaParser.getSpeed();
    double ratio = history.getGlideRatio(currentSpeed, serialNmea.getReceiveTimestamp());

 #ifdef HAVE_SCREEN_JPG63
     flystat.SetSpeed(currentSpeed);
 #endif //HAVE_SCREEN_JPG63

    // display speed and ratio    
    if (currentSpeed > 99)      speedDigit.setValue( 99 );
    else                        speedDigit.setValue( currentSpeed );

    if( currentSpeed >= RATIO_MIN_SPEED && ratio >= 0.0 && ratio < RATIO_MAX_VALUE ) {
      ratioDigit.setValue(ratio);
    } else {
      ratioDigit.setValue(0.0);
    }
  }

#endif //HAVE_GPS

  recordIndicator.stateRECORD();

  /* screen update */
  varioScreen.displayStep();

#endif //HAVE_SCREEN

  flystat.Handle(); 
}

#if defined(HAVE_SDCARD) && defined(HAVE_GPS)
void createSDCardTrackFile(void) {
  /* start the sdcard record */
  if( sdcardState == SDCARD_STATE_INITIALIZED ) {

    /* some cards doesn't like delays between init and write, so reinit */
    file.init();
  
    /* build date : convert from DDMMYY to YYMMDD */
    uint8_t dateChar[8]; //two bytes are used for incrementing number on filename
    uint8_t* dateCharP = dateChar;
    uint32_t date = nmeaParser.date;
    for(uint8_t i=0; i<3; i++) {
      uint8_t num = ((uint8_t)(date%100));
      dateCharP[0] = (num/10) + '0';
      dateCharP[1] = (num%10) + '0';
      dateCharP += 2;
      date /= 100;
    }

    /* create file */    
    if( file.begin((char*)dateChar, 8) >= 0 ) {
      sdcardState = SDCARD_STATE_READY;
            
      /* write the header */
      int16_t datePos = header.begin();
      if( datePos >= 0 ) {
        while( datePos ) {
        file.write(header.get());
          datePos--;
        }

        /* write date : DDMMYY */
        uint8_t* dateCharP = &dateChar[4];
        for(int i=0; i<3; i++) {
          file.write(dateCharP[0]);
          file.write(dateCharP[1]);
          header.get();
          header.get();
          dateCharP -= 2;
        }
            
        while( header.available() ) {
          file.write(header.get());
        }
      }
    } else {
      sdcardState = SDCARD_STATE_ERROR; //avoid retry 
    }
  }
}
#endif //defined(HAVE_SDCARD) && defined(HAVE_GPS)



void enableflightStartComponents(void) {

#if defined( HAVE_SPEAKER) && defined(ALARM_FLYBEGIN)

for( int i = 0; i<2; i++) {
   toneHAL.tone(BEEP_FREQ);
   delay(200);
   toneHAL.tone(0);
   delay(200);
}
#endif //HAVE_SPEAKER && ALARM_FLYBEGIN
  
//display record
#ifdef HAVE_SCREEN
recordIndicator.setActifRECORD();
#endif //HAVE_SCREEN

  /* set base time */
#if defined(HAVE_SCREEN) && defined(HAVE_GPS)
  screenElapsedTime.setBaseTime( screenTime.getTime() );
#endif //defined(HAVE_SCREEN) && defined(HAVE_GPS)

  /* enable near climbing */
#ifdef HAVE_SPEAKER
#ifdef VARIOMETER_ENABLE_NEAR_CLIMBING_ALARM
  beeper.setGlidingAlarmState(true);
#endif
#ifdef VARIOMETER_ENABLE_NEAR_CLIMBING_BEEP
  beeper.setGlidingBeepState(true);
#endif
#endif //HAVE_SPEAKER

#if defined(HAVE_SDCARD) && defined(HAVE_GPS) && defined(VARIOMETER_RECORD_WHEN_FLIGHT_START)
  createSDCardTrackFile();
#endif // defined(HAVE_SDCARD) && defined(VARIOMETER_RECORD_WHEN_FLIGHT_START)
#ifdef HAVE_SCREEN_JPG63
  flystat.Begin();
//  CalculTrend.Enable();
#endif //HAVE_SCREEN_JPG63
}
