prunkdump/arduino-variometer/(commit log)

2016-09-23 add schematic
2016-10-06 switch all library to arduino SPI
2016-10-10 add accelerometer calibration
2016-10-15 improved calibration code
2016-10-17 remove multi-imu feature from rpicopter_lib to save space
2016-10-29 added speed mean filter
2016-11-04 adjust interrupt time
2016-11-17 added fritzing file
    [variometer.fzz]
2017-01-14 added calibration to EEPROM, improved calibration
2017-03-02 added NMEA filter
2017-03-05 switch varioscreen to digit library
2017-03-05 switched to new NMEA library
2017-03-23 remove SS high from SPI begin
2017-03-23 more conservative I2C parameters
2017-03-23 change default pins from schematics
2017-03-24 bluetooth does not work yet
    [variometer.ino]
2017-03-25 use hardware serial : GPS -> Arduino RX, Arduino TX -> bluetooth
2017-05-03 wait before starting calibration
2017-05-15 change altitude calibration method
2017-05-23 corrected bug : date not send on first NMEA sentences
    [variometer.ino]
2017-05-23 pin numbers changed accidentally
2017-05-23 separate sdcard and bluetooth calibrated altitude
2017-06-07 Added : GPS level, Battery level
2017-06-09 Corrected bug : battery level
2017-06-15 Corrected bug : date in IGC files
    [variometer.ino]
2017-06-15 Corrected bug : IGC Header
    [variometer.ino]
2017-07-20 improved documentation
    [variometer.fzz]
2017-08-18 added : pressure on LK8000 sentences
2017-09-19 modified to jpg63 version
    [variometer v2.fzz]
2017-09-20 Correct code for multiple SPI devices
    [variometer.ino]
2017-09-21 Added : Three phased Low Power toneAC
2017-09-25 added : delay on IMU init
2017-10-09 connect InvenSense library to I2Cdev_ms5611
2017-10-12 Corrected bug : DMP sample rate computation
2017-10-12 calibration_nointeractive : added Gyro calibration delay
2017-10-29 screen pin modification
2017-11-07 LightInvensense : added magnetometer support
2018-01-24 Added magnometer calibration support
2018-03-08 I2CDev_ms5611 : const correction
2018-03-08 vertaccel : added magnetometer support
2018-03-08 Corrected mag calibration
2018-03-08 Added : best fit calibration
2018-03-08 calibration_nointeractive : added start delay
2018-03-08 renamed accel calibration sketches
2018-06-01 Corrected Bug : calibration scale computation
    [mag_calibration.ino, mag_calibration_nointeractive.ino]
2019-03-12 Version 63.8.1 - bug fix RATIO_CLIMB_RATE / Maj ToneHAL
    [variometer.ino]
2019-03-20 Version 63.9.1 - bug fix
    [variometer.ino]
2019-03-26 Version 63.9.3 - fixes the issue of update by rollback
    [variometer.ino]
2019-03-27 Corrected bug : FirmwareUpdaterTWS can't compile without accelerometer
    [calibration_recorder.ino]
2019-04-03 added material change documentation
