prunkdump/arduino-variometer/(notices)

Notices in the files:
gps_time_analysis/gps_time_analysis.ino:
GNUVario is free software: you can redistribute it and/or modify
it under the terms of the GNU General Public License as published by
the Free Software Foundation, either version 3 of the License, or
(at your option) any later version.
